gdgly/dca-270/DOC/上尚装置图片_160718/4.jpg

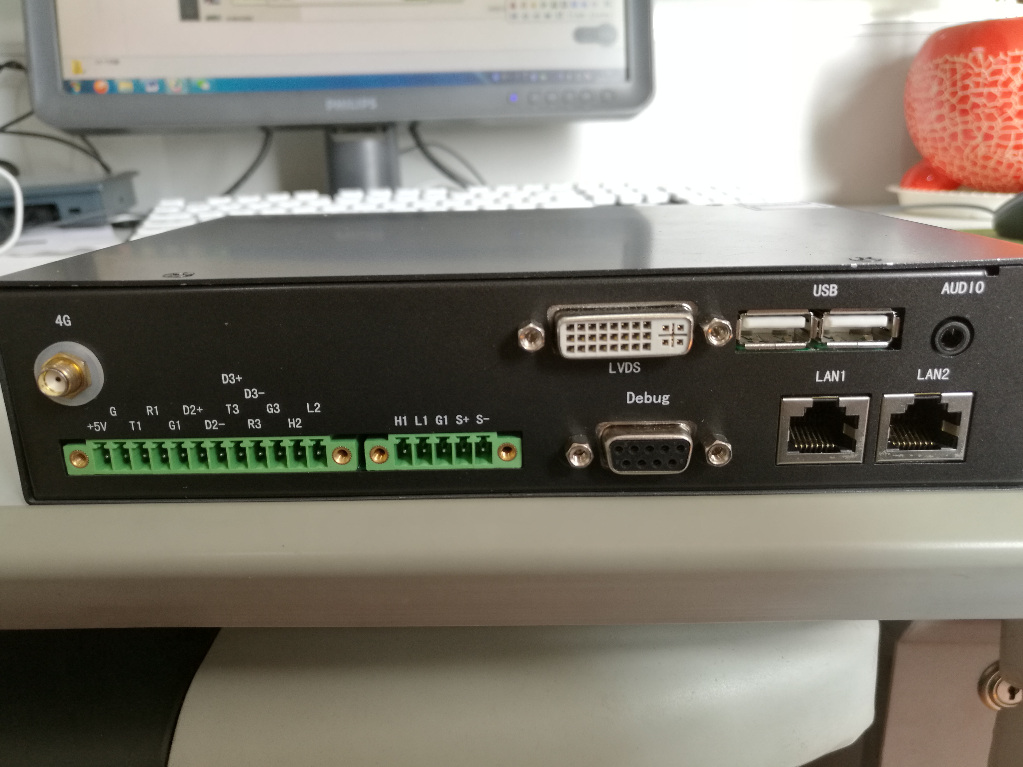
DOC/上尚装置图片_160718/4.jpg
