gdgly/dca-270/README.md

#DCA-270
* 该项目是根据许继技术中心需求而设计的产品，产品名称为*DCA-270*，对应许继的产品型号为*ECU-801*。
* 进行该产品的设计，是作为__网外直流桩的计费控制单元__推出，在价格上比*DCA-400*要低一些。
