gdgly/dca-270/DOC/上尚装置图片_160718/3.jpg

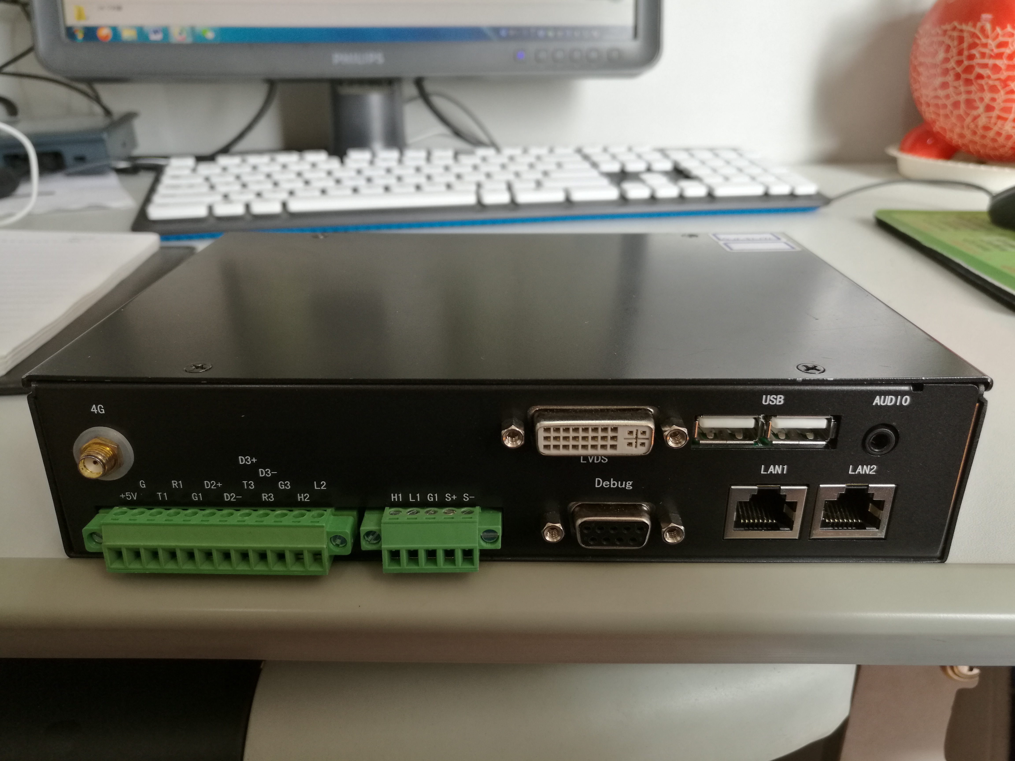
DOC/上尚装置图片_160718/3.jpg
