gdgly/dca-270/DOC/BOM清单上需要去掉的器件_160823.docx

1. 在DCA-270硬件上，考虑到冗余设计，增加了一些相对冗余的电路，可以把这些器件去掉，以起到节省成本的目的。
2. EB板上可以去掉的器件：

B3

C48、C50、

CE1、CE2、CE3、CE8、CE9、CE12、

CY2

DCDC1

R52

3. MB板上可以去掉的器件：

CE15、CE16、CE17、CE18、CE19、CE20、CE21、CE22、CE23
