gdgly/dca-270/SCH_160723/DCA_270_EB_V20_160723/dca_270_eb_v20_160723.pdf

D | D
C | C
B | B
A | A
1.0 | FEATURE CHANGES 1、完成1.0版本原理图设计。 说明：采用两层板设计方案。 2、2016.04.28：图纸做了修改，将MB板上的4G模块电源电路 和音频功放电路移到EB板上。这样MB板上就没有12V强电了。 | 04/20/16 | Jason
REV | DESCRIPTION | DATE | BY

# CONTENTS

PAGE NO. | SCHEMATIC PAGE
1 | 封面
2 | 板对板接插件：2 * 40pin 双排2.54mm插针
3 | RJ45电路
4 | RS232电路
5 | RS485电路
6 | CAN总线接口电路
7 | 2路DI开入电路
8 | 2路DO开出电路
9 | 音频放大电路
10 | 4G无线模块电源
11 | 12V输入，产生系统主3.3/5V电源
12 | 外部12V电源EMC滤波电路
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
2.0 | FEATURE CHANGES 1、按照克潇ECU801需求，重新改动图纸。 2、EB板上一共排布有7个端子，分别为： J1：电源端子 J2：DI开入端子 J3：DO开出端子 J7：串口端子 J8：CAN和音频端子 J9：DEBUG调试串口DB9母头 J10：以太网RJ45端口 | 07/23/16 | Jason

## Jason

标记 标记 标记 | 数量更改单号签名日期 更改 数量更改单号签名日期 更改 数量更改单号签名日期 更改 | | | 更改 更改 更改 标记 标记 标记 | 数量更改单号 数量更改单号 数量更改单号 | | 签名 签名日期 更改标记 数量更改单号 签名 签名日期 更改标记 数量更改单号 签名 签名日期 更改标记 数量更改单号 | 日期 日期 日期
拟制 拟制 拟制 | | Jason.Wang Jason.Wang Jason.Wang | COVER COVER COVER | | | DCA-270_EB DCA-270_EB DCA-270_EB
审核 审核 审核 | | <审核> <审核> <审核>
批准 | <批准>
版本 | 第　　张 | 共　　张
V2.0 V2.0 V2.0 | 1 1 1 | 12 12 12

# 标准化

注意：

# 该接插件可放置在板子的左边。

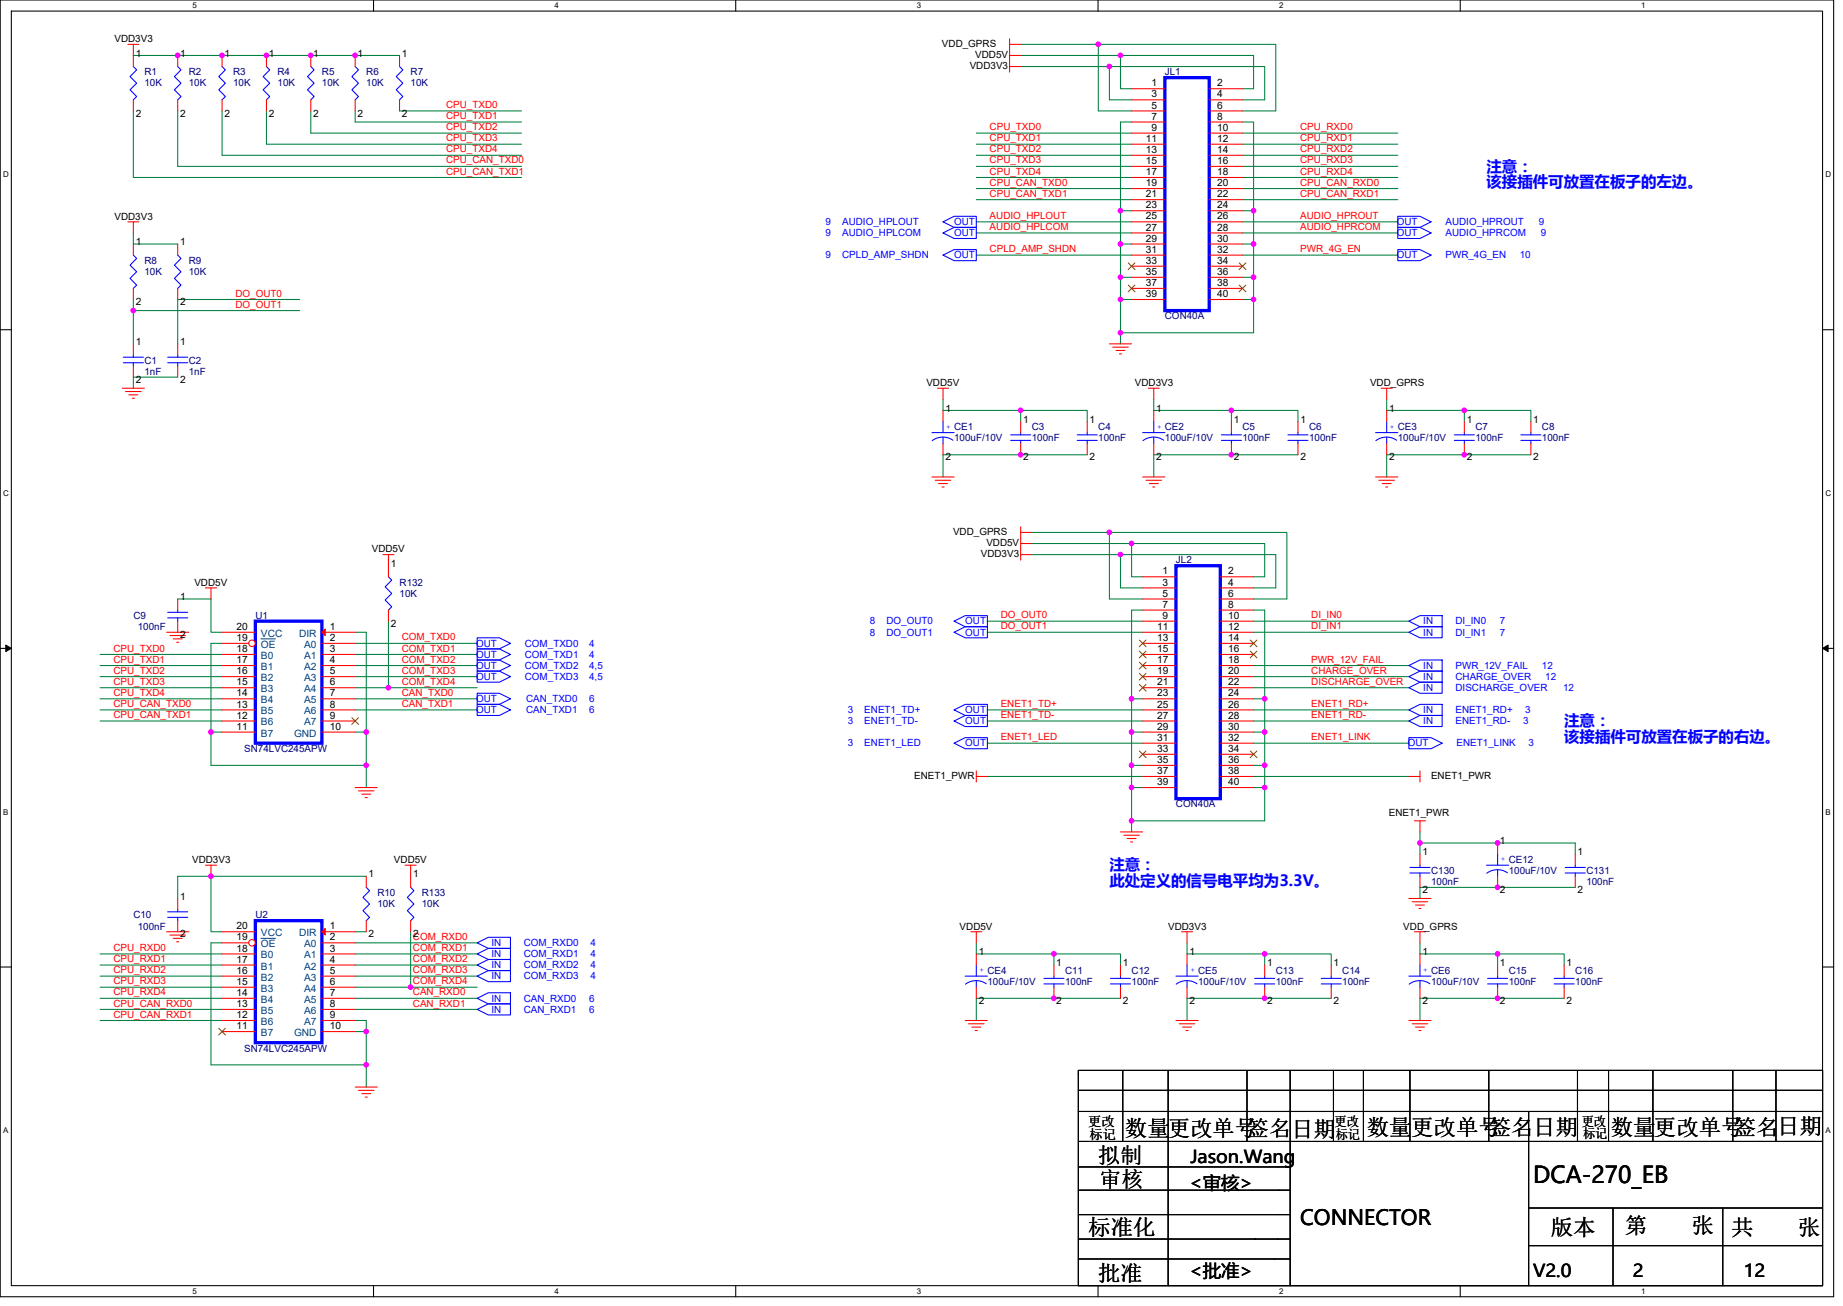
[picture p11: page 2]

37 | 38
39 | 40

标记 标记 标记 | 数量更改单号签名日期 更改 数量更改单号签名日期 更改 数量更改单号签名日期 更改 | | | 更改 更改 更改 标记 标记 标记 | 数量更改单号 数量更改单号 数量更改单号 | | 签名 签名日期 更改标记 数量更改单号 签名 签名日期 更改标记 数量更改单号 签名 签名日期 更改标记 数量更改单号 | 日期 日期 日期
拟制 拟制 拟制 | | Jason.Wang Jason.Wang Jason.Wang | CONNECTOR CONNECTOR CONNECTOR | | | DCA-270_EB DCA-270_EB DCA-270_EB
审核 审核 审核 | | <审核> <审核> <审核>

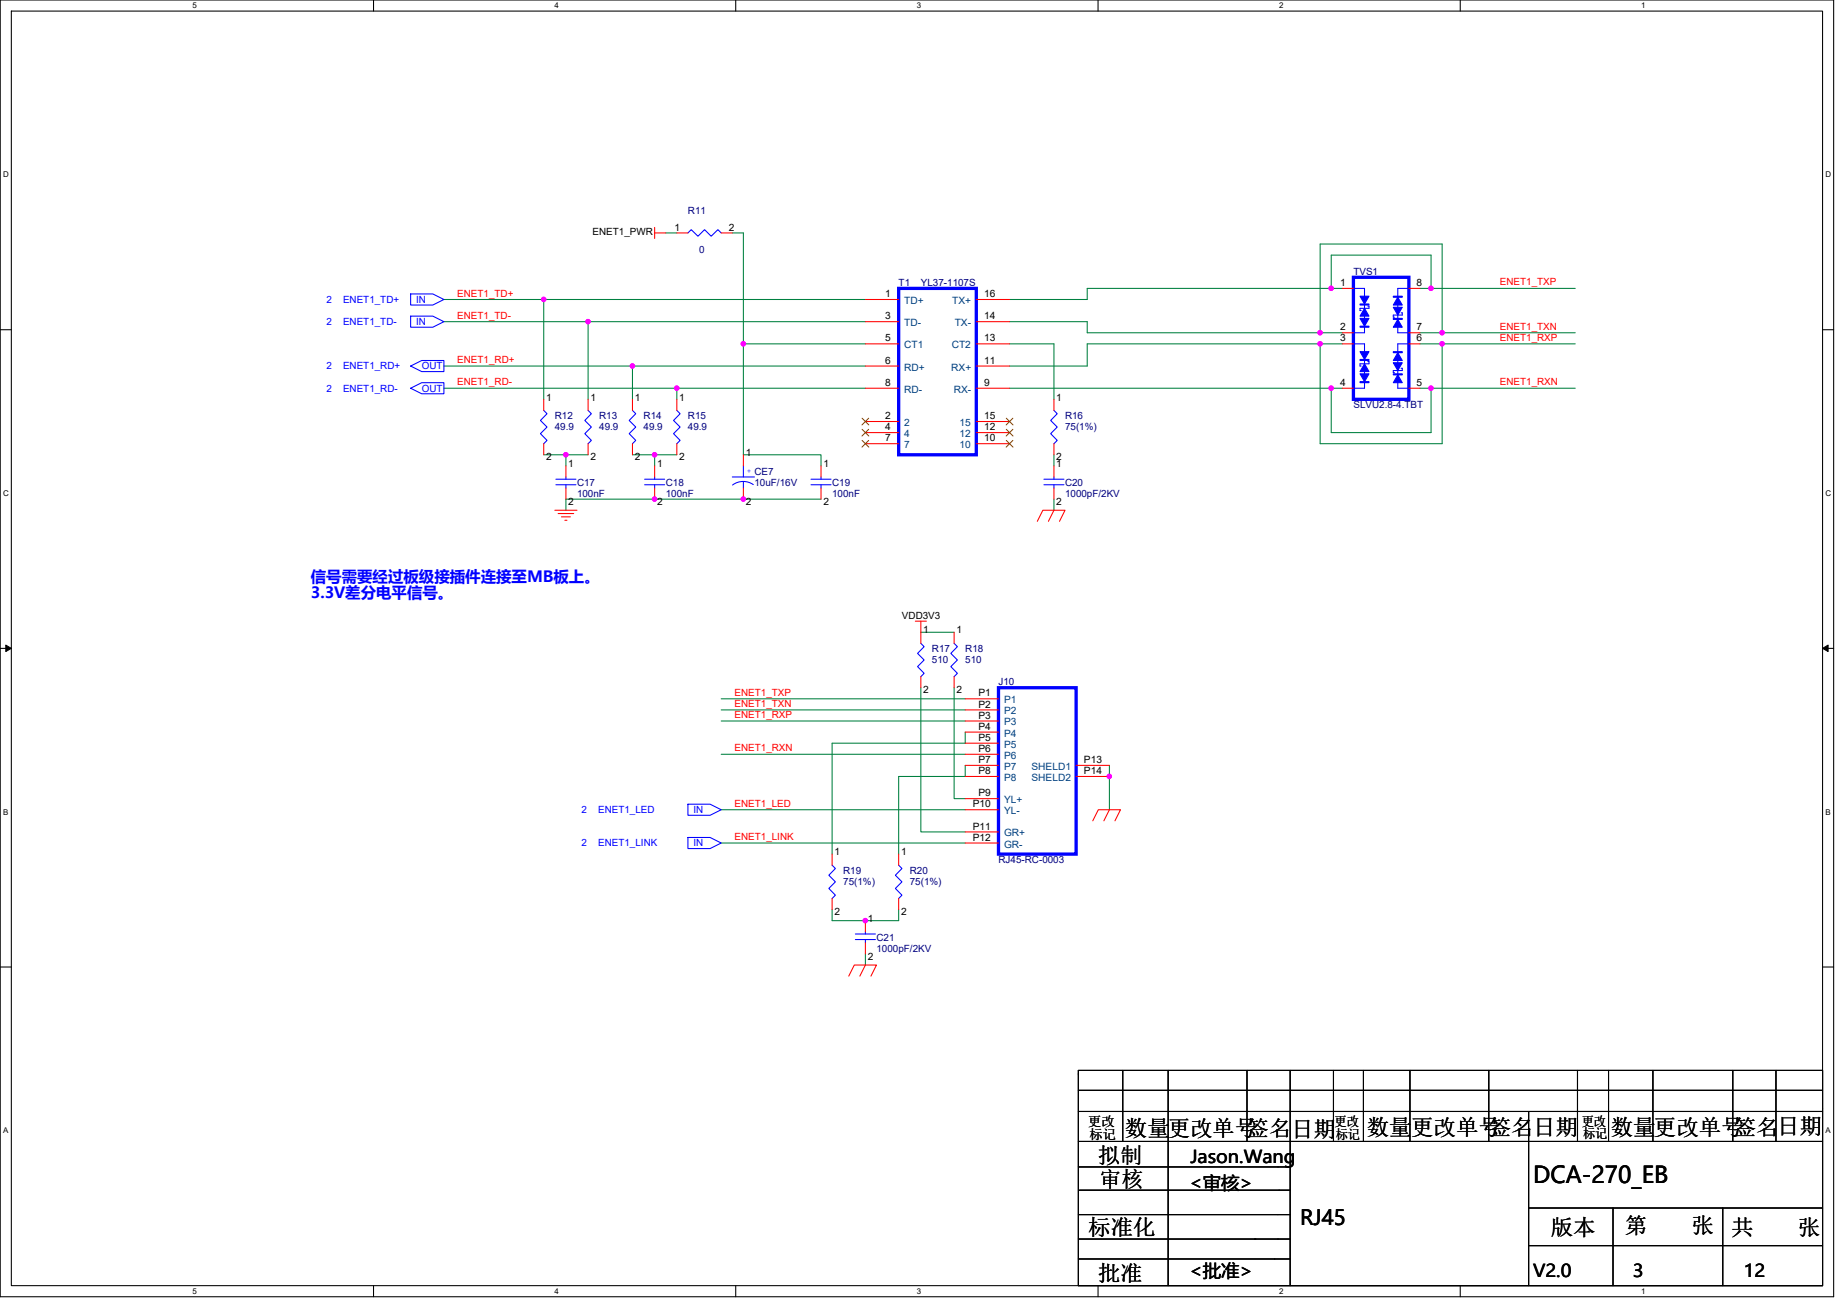
[picture p12: page 3]

标记 标记 标记 | 数量更改单号签名日期 更改 数量更改单号签名日期 更改 数量更改单号签名日期 更改 | | | 更改 更改 更改 标记 标记 标记 | 数量更改单号 数量更改单号 数量更改单号 | | 签名 签名日期 更改标记 数量更改单号 签名 签名日期 更改标记 数量更改单号 签名 签名日期 更改标记 数量更改单号 | 日期 日期 日期
拟制 拟制 拟制 | | Jason.Wang Jason.Wang Jason.Wang | RJ45 RJ45 RJ45 | | | DCA-270_EB DCA-270_EB DCA-270_EB
审核 审核 审核 | | <审核> <审核> <审核>

# 采用90度弯针DB9母头。

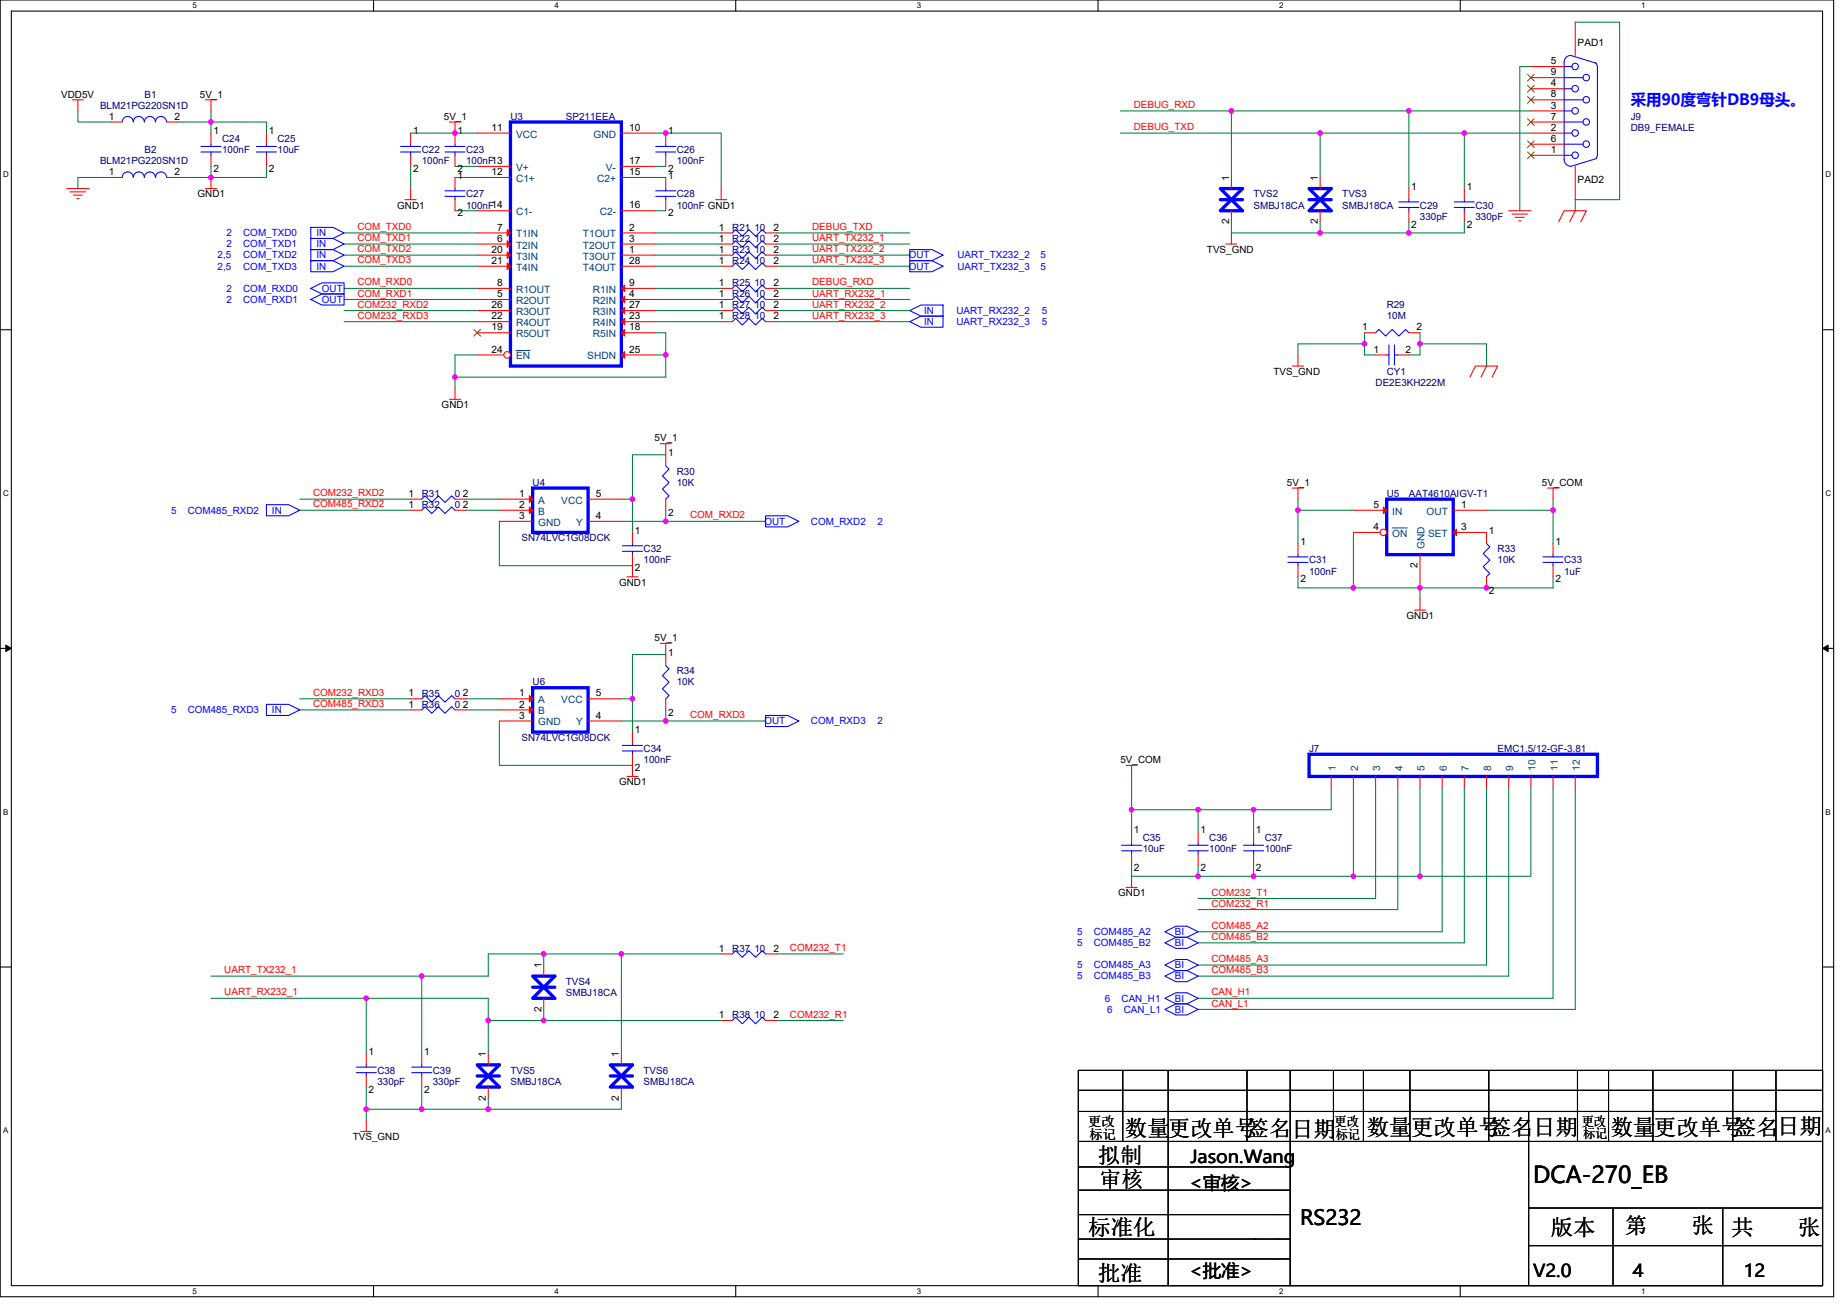
[picture p13: page 4]

COM232_T1

标记 标记 标记 | 数量更改单号签名日期 更改 数量更改单号签名日期 更改 数量更改单号签名日期 更改 | | | 更改 更改 更改 标记 标记 标记 | 数量更改单号 数量更改单号 数量更改单号 | | 签名 签名日期 更改标记 数量更改单号 签名 签名日期 更改标记 数量更改单号 签名 签名日期 更改标记 数量更改单号 | 日期 日期 日期
拟制 拟制 拟制 | | Jason.Wang Jason.Wang Jason.Wang | RS232 RS232 RS232 | | | DCA-270_EB DCA-270_EB DCA-270_EB
审核 审核 审核 | | <审核> <审核> <审核>

注意：

# 本页图纸统一将上下拉电阻改为560欧姆

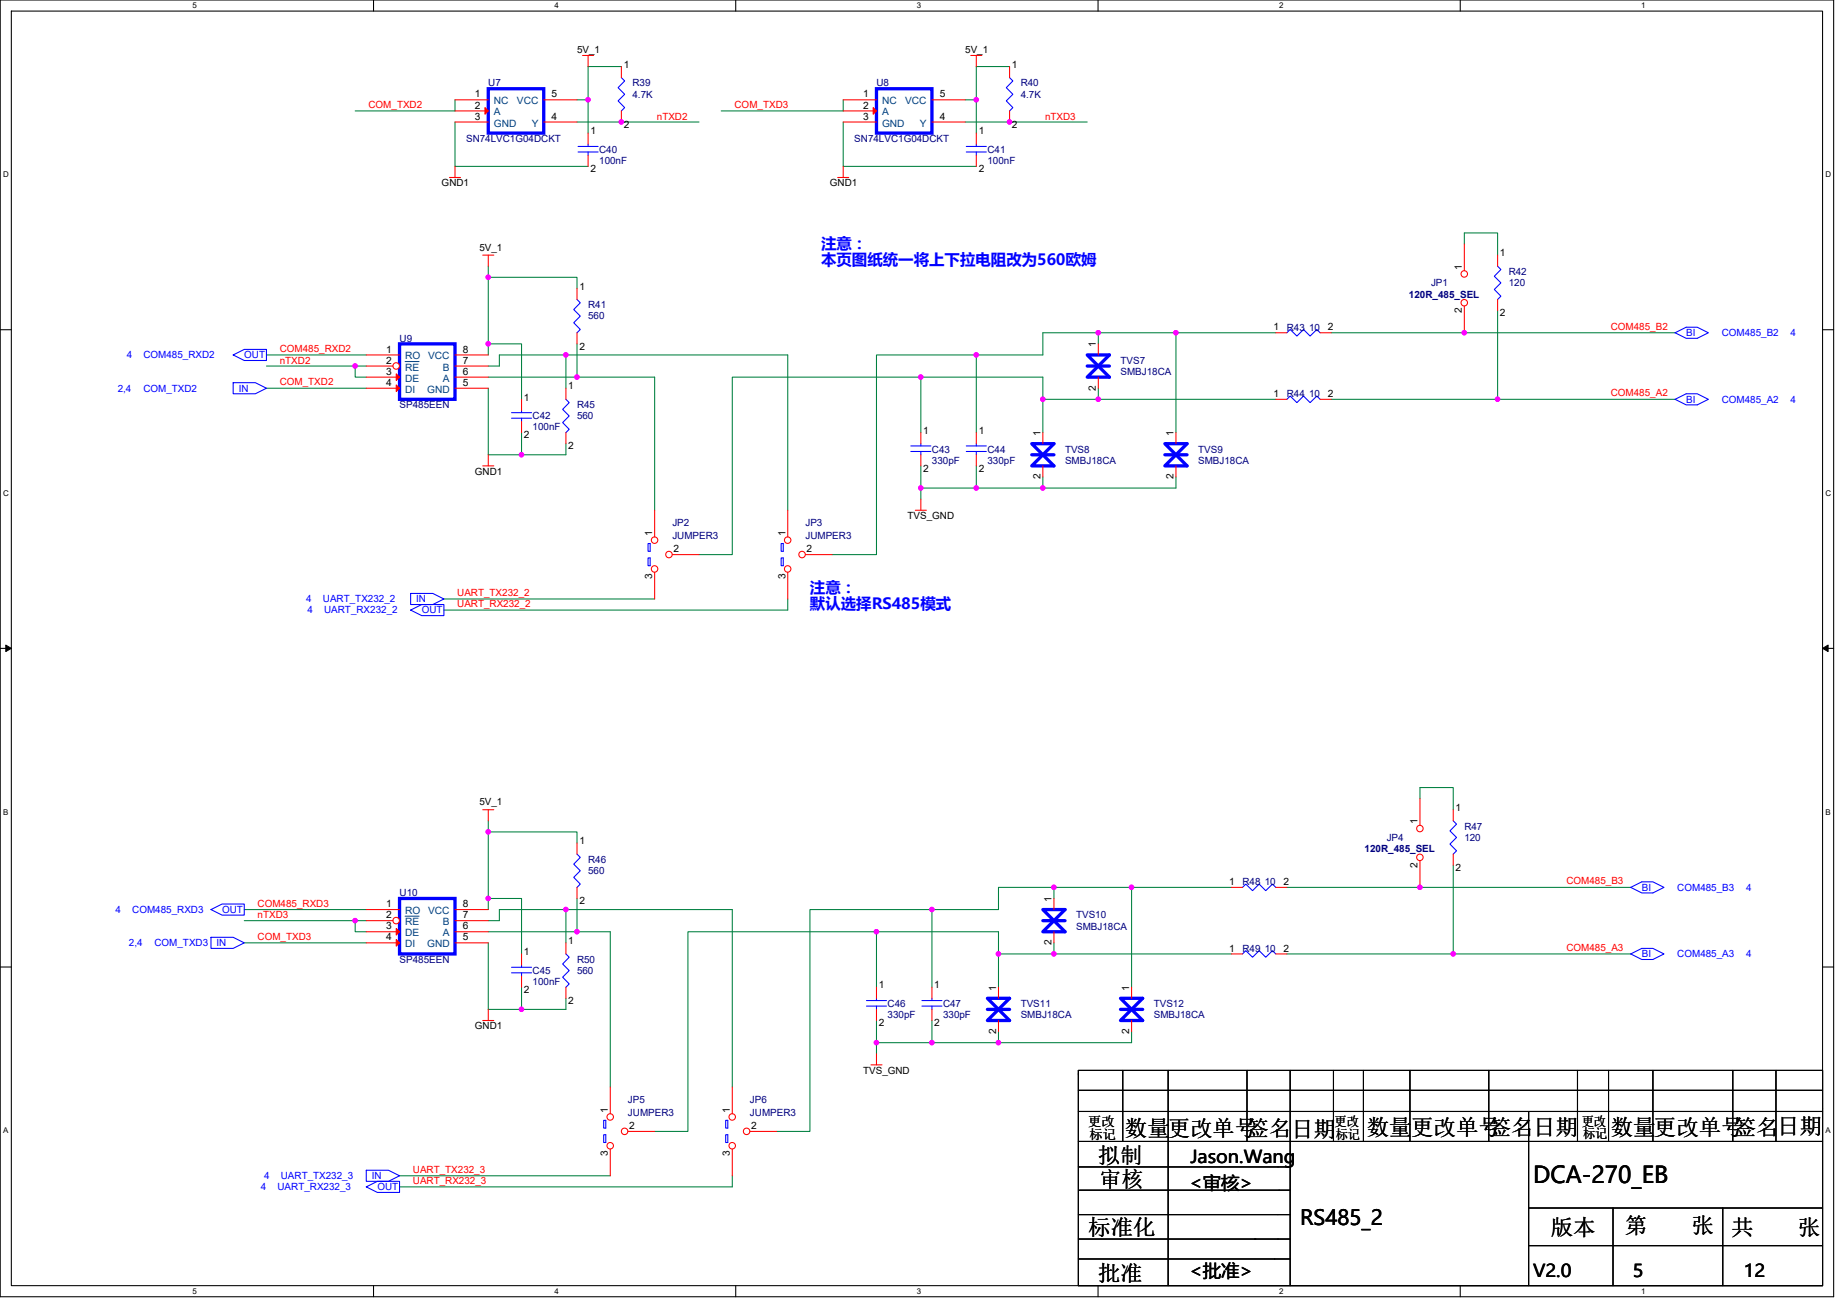
[picture p14: page 5]

标记 标记 标记 | 数量更改单号签名日期 更改 数量更改单号签名日期 更改 数量更改单号签名日期 更改 | | | 更改 更改 更改 标记 标记 标记 | 数量更改单号 数量更改单号 数量更改单号 | | 签名 签名日期 更改标记 数量更改单号 签名 签名日期 更改标记 数量更改单号 签名 签名日期 更改标记 数量更改单号 | 日期 日期 日期
拟制 拟制 拟制 | | Jason.Wang Jason.Wang Jason.Wang | RS485_2 RS485_2 RS485_2 | | | DCA-270_EB DCA-270_EB DCA-270_EB
审核 审核 审核 | | <审核> <审核> <审核>

# 考虑成本，该部分电路不焊接。

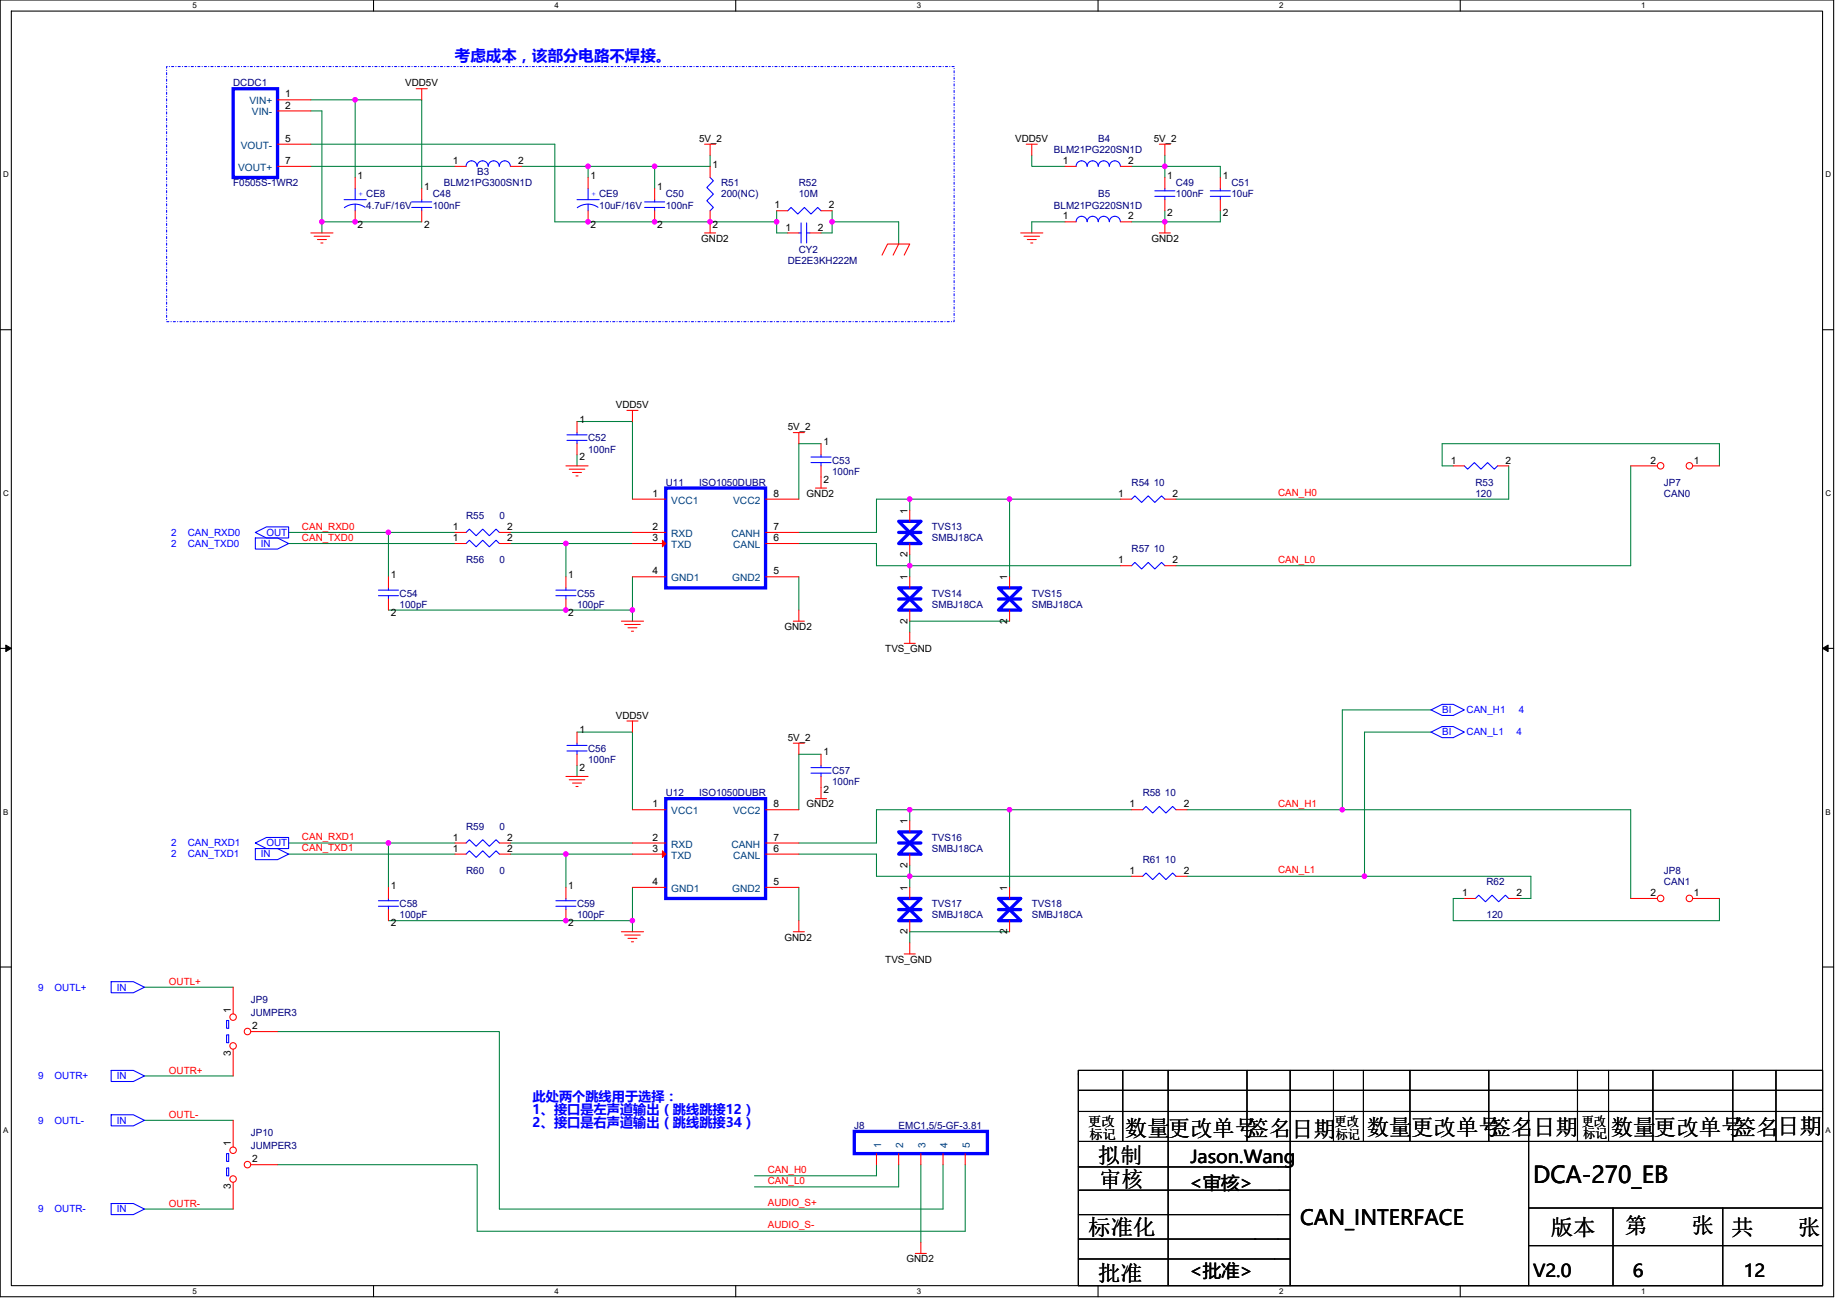
[picture p15: page 6]

OUTL+ OUTR+ OUTL- OUTR-

标记 标记 标记 | 数量更改单号签名日期 更改 数量更改单号签名日期 更改 数量更改单号签名日期 更改 | | | 更改 更改 更改 标记 标记 标记 | 数量更改单号 数量更改单号 数量更改单号 | | 签名 签名日期 更改标记 数量更改单号 签名 签名日期 更改标记 数量更改单号 签名 签名日期 更改标记 数量更改单号 | 日期 日期 日期
拟制 拟制 拟制 | | Jason.Wang Jason.Wang Jason.Wang | CAN_INTERFACE CAN_INTERFACE CAN_INTERFACE | | | DCA-270_EB DCA-270_EB DCA-270_EB
审核 审核 审核 | | <审核> <审核> <审核>

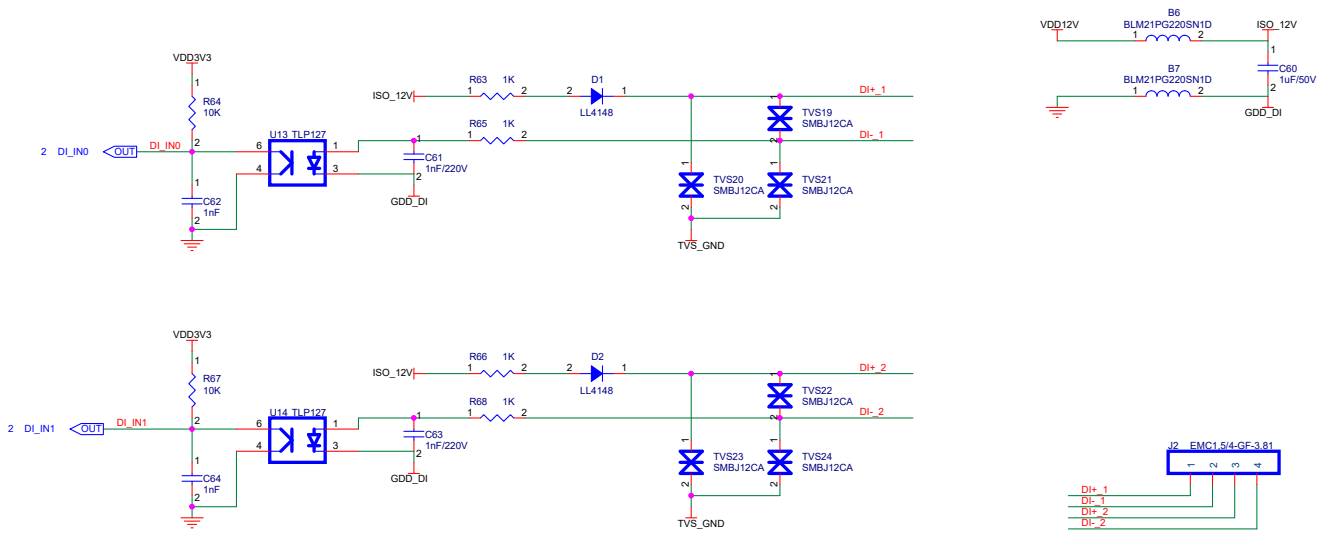
[picture p16: page 7]

标记 标记 标记 | 数量更改单号签名日期 更改 数量更改单号签名日期 更改 数量更改单号签名日期 更改 | | | 更改 更改 更改 标记 标记 标记 | 数量更改单号 数量更改单号 数量更改单号 | | 签名 签名日期 更改标记 数量更改单号 签名 签名日期 更改标记 数量更改单号 签名 签名日期 更改标记 数量更改单号 | 日期 日期 日期
拟制 拟制 拟制 | | Jason.Wang Jason.Wang Jason.Wang | DIO INPUT DIO INPUT DIO INPUT | | | DCA-270_EB DCA-270_EB DCA-270_EB
审核 审核 审核 | | <审核> <审核> <审核>

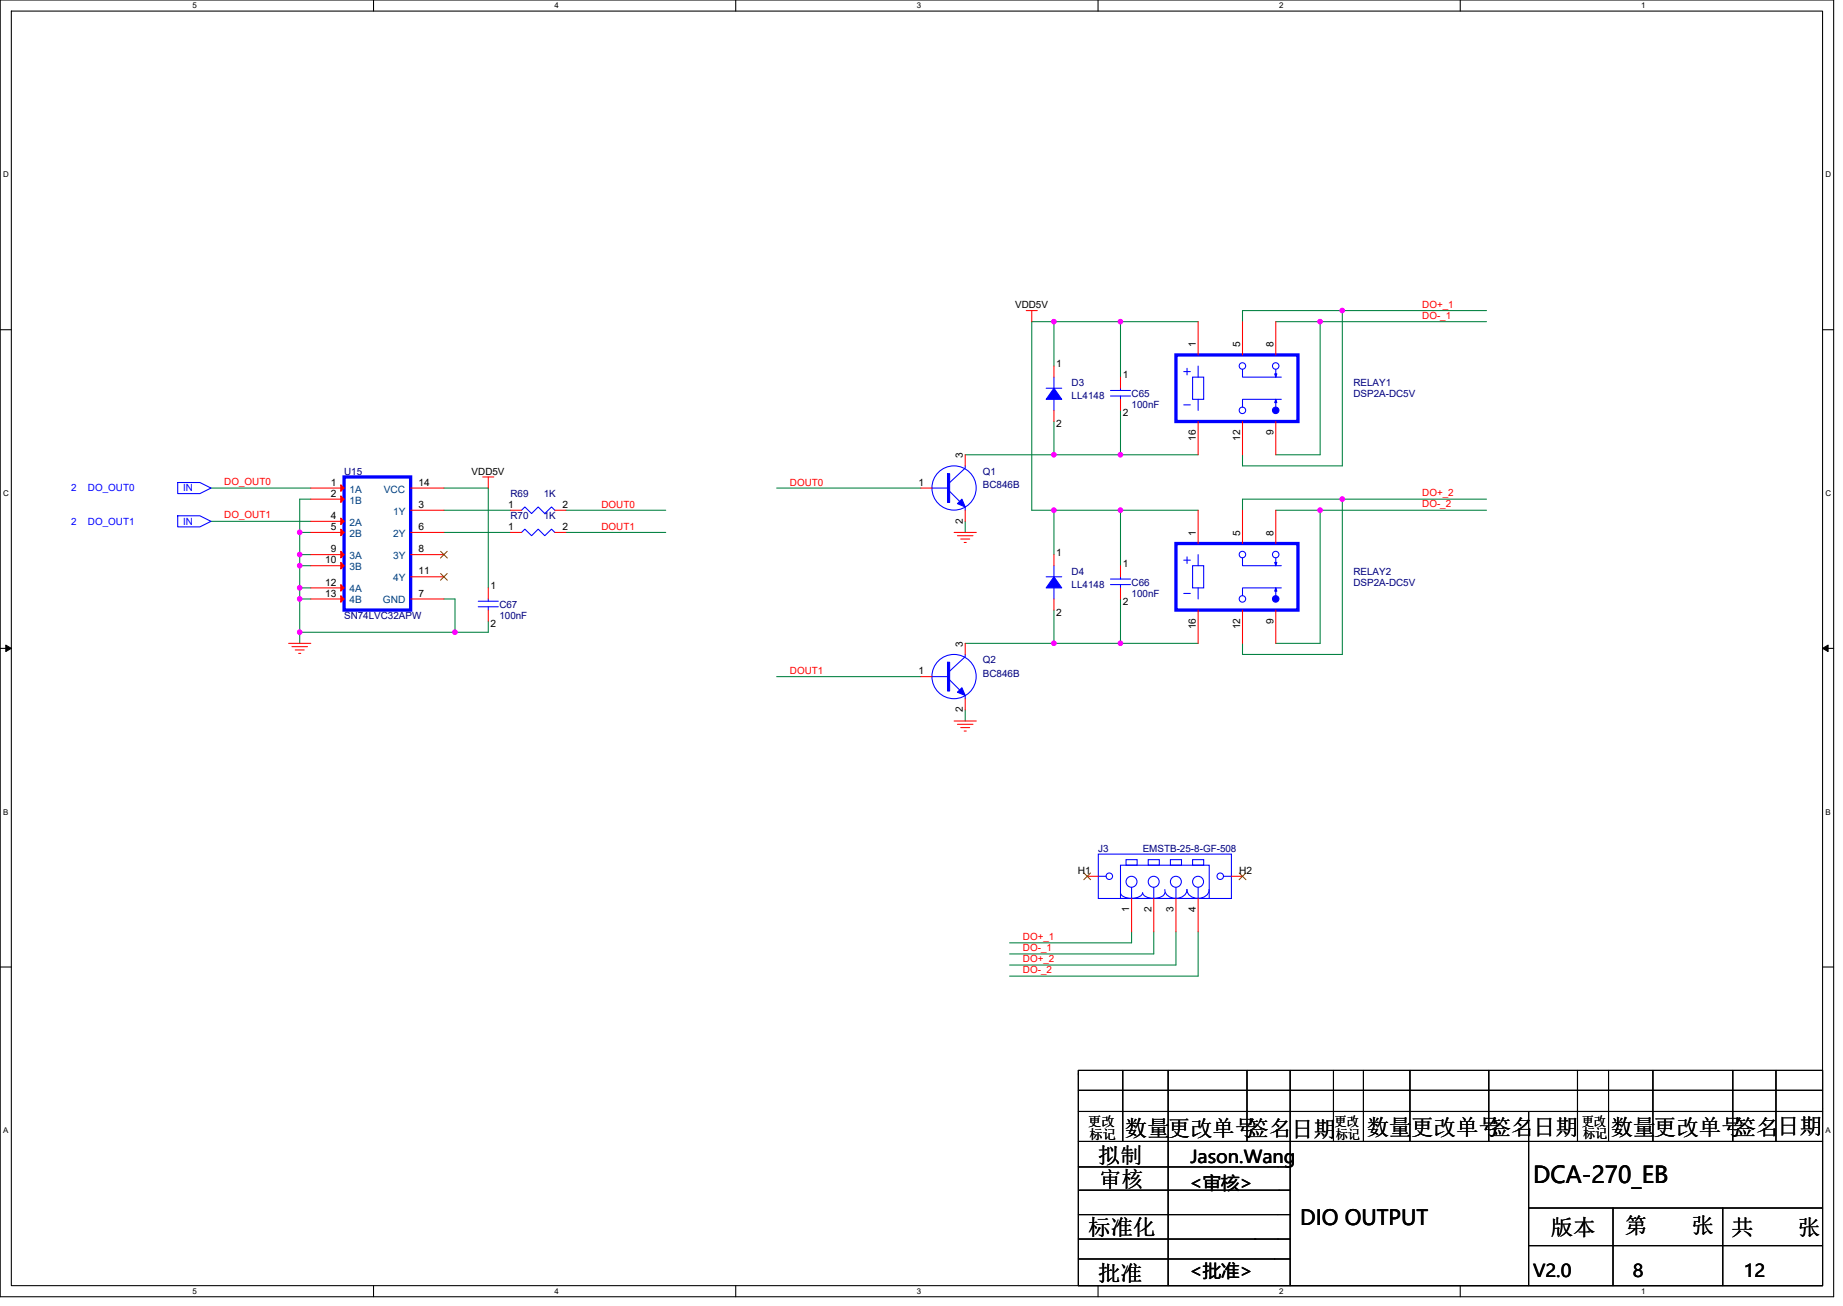
[picture p17: page 8]

标记 标记 标记 | 数量更改单号签名日期 更改 数量更改单号签名日期 更改 数量更改单号签名日期 更改 | | | 更改 更改 更改 标记 标记 标记 | 数量更改单号 数量更改单号 数量更改单号 | | 签名 签名日期 更改标记 数量更改单号 签名 签名日期 更改标记 数量更改单号 签名 签名日期 更改标记 数量更改单号 | 日期 日期 日期
拟制 拟制 拟制 | | Jason.Wang Jason.Wang Jason.Wang | DIO OUTPUT DIO OUTPUT DIO OUTPUT | | | DCA-270_EB DCA-270_EB DCA-270_EB
审核 审核 审核 | | <审核> <审核> <审核>

D | D

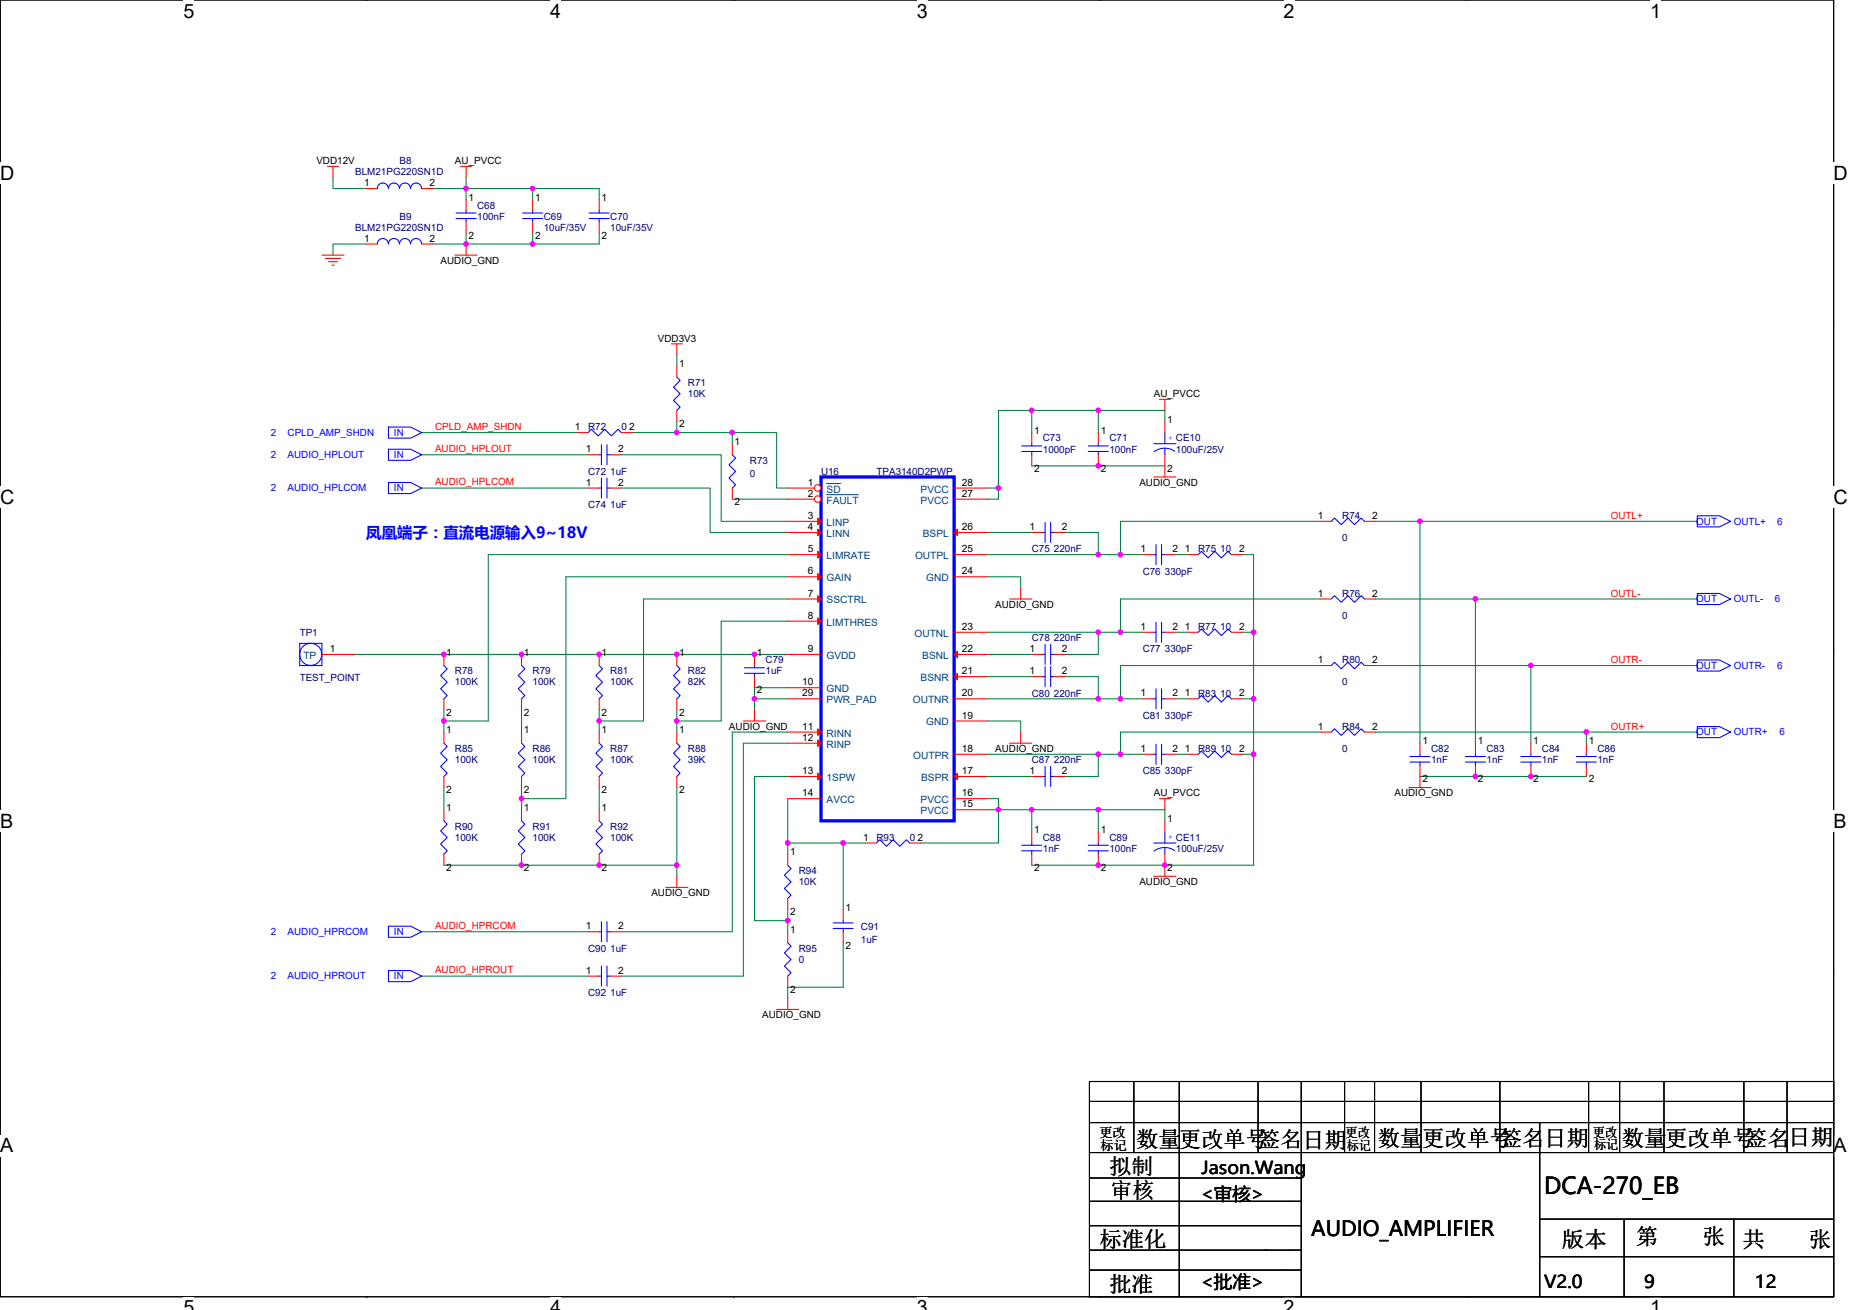
[picture p18: page 9]

标记 标记 标记 | 数量更改单号签名日期 更改 数量更改单号签名日期 更改 数量更改单号签名日期 更改 | | | 更改 更改 更改 标记 标记 标记 | 数量更改单号 数量更改单号 数量更改单号 | | 签名 签名日期 更改标记 数量更改单号 签名 签名日期 更改标记 数量更改单号 签名 签名日期 更改标记 数量更改单号 | 日期 日期 日期
拟制 拟制 拟制 | | Jason.Wang Jason.Wang Jason.Wang | AUDIO_AMPLIFIER AUDIO_AMPLIFIER AUDIO_AMPLIFIER | | | DCA-270_EB DCA-270_EB DCA-270_EB
审核 审核 审核 | | <审核> <审核> <审核>

D | D

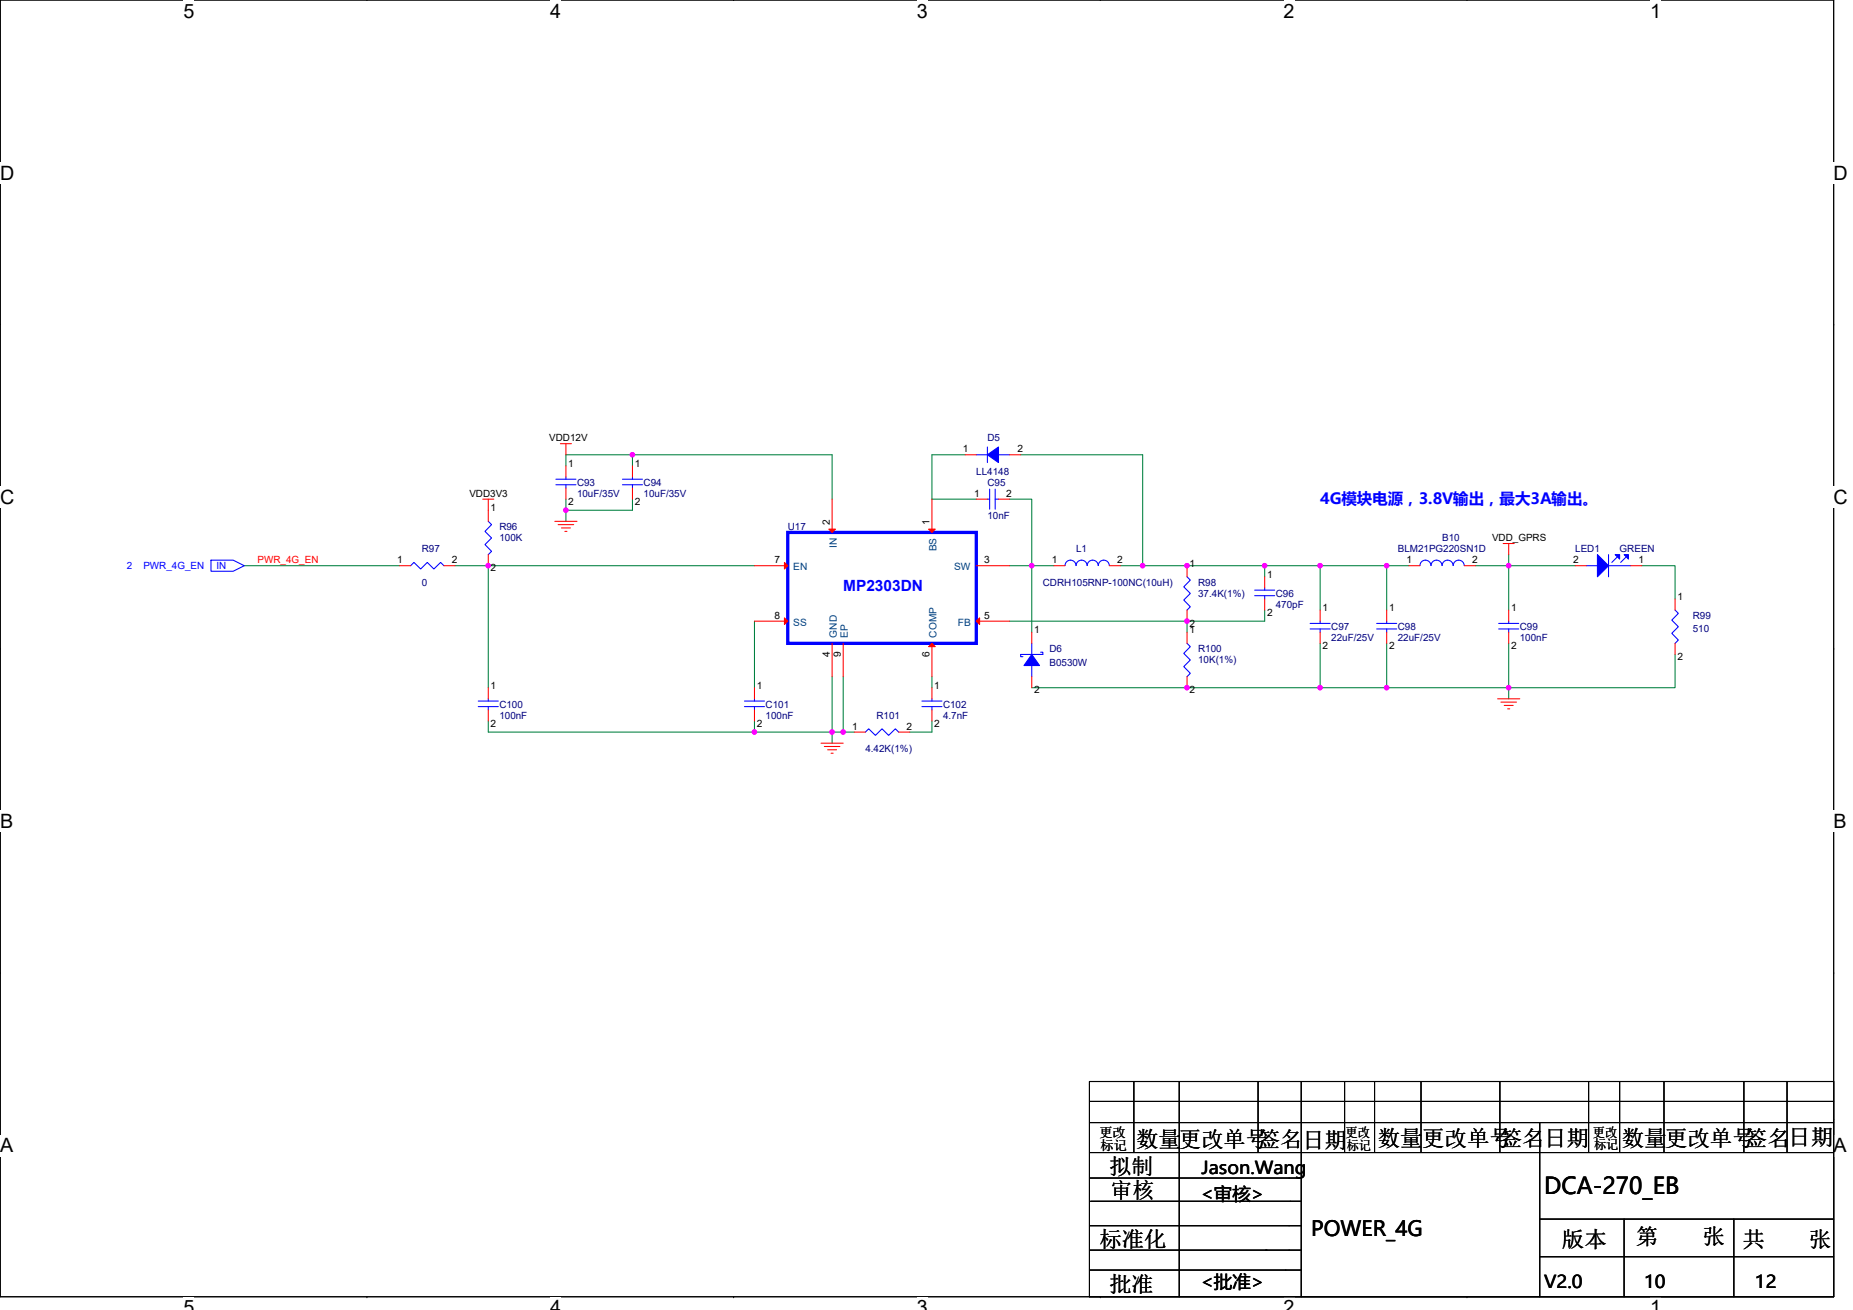
[picture p19: page 10]

标记 标记 标记 | 数量更改单号签名日期 更改 数量更改单号签名日期 更改 数量更改单号签名日期 更改 | | | 更改 更改 更改 标记 标记 标记 | 数量更改单号 数量更改单号 数量更改单号 | | 签名 签名日期 更改标记 数量更改单号 签名 签名日期 更改标记 数量更改单号 签名 签名日期 更改标记 数量更改单号 | 日期 日期 日期
拟制 拟制 拟制 | | Jason.Wang Jason.Wang Jason.Wang | POWER_4G POWER_4G POWER_4G | | | DCA-270_EB DCA-270_EB DCA-270_EB
审核 审核 审核 | | <审核> <审核> <审核>

# 系统主5V电源，最大3A输出。

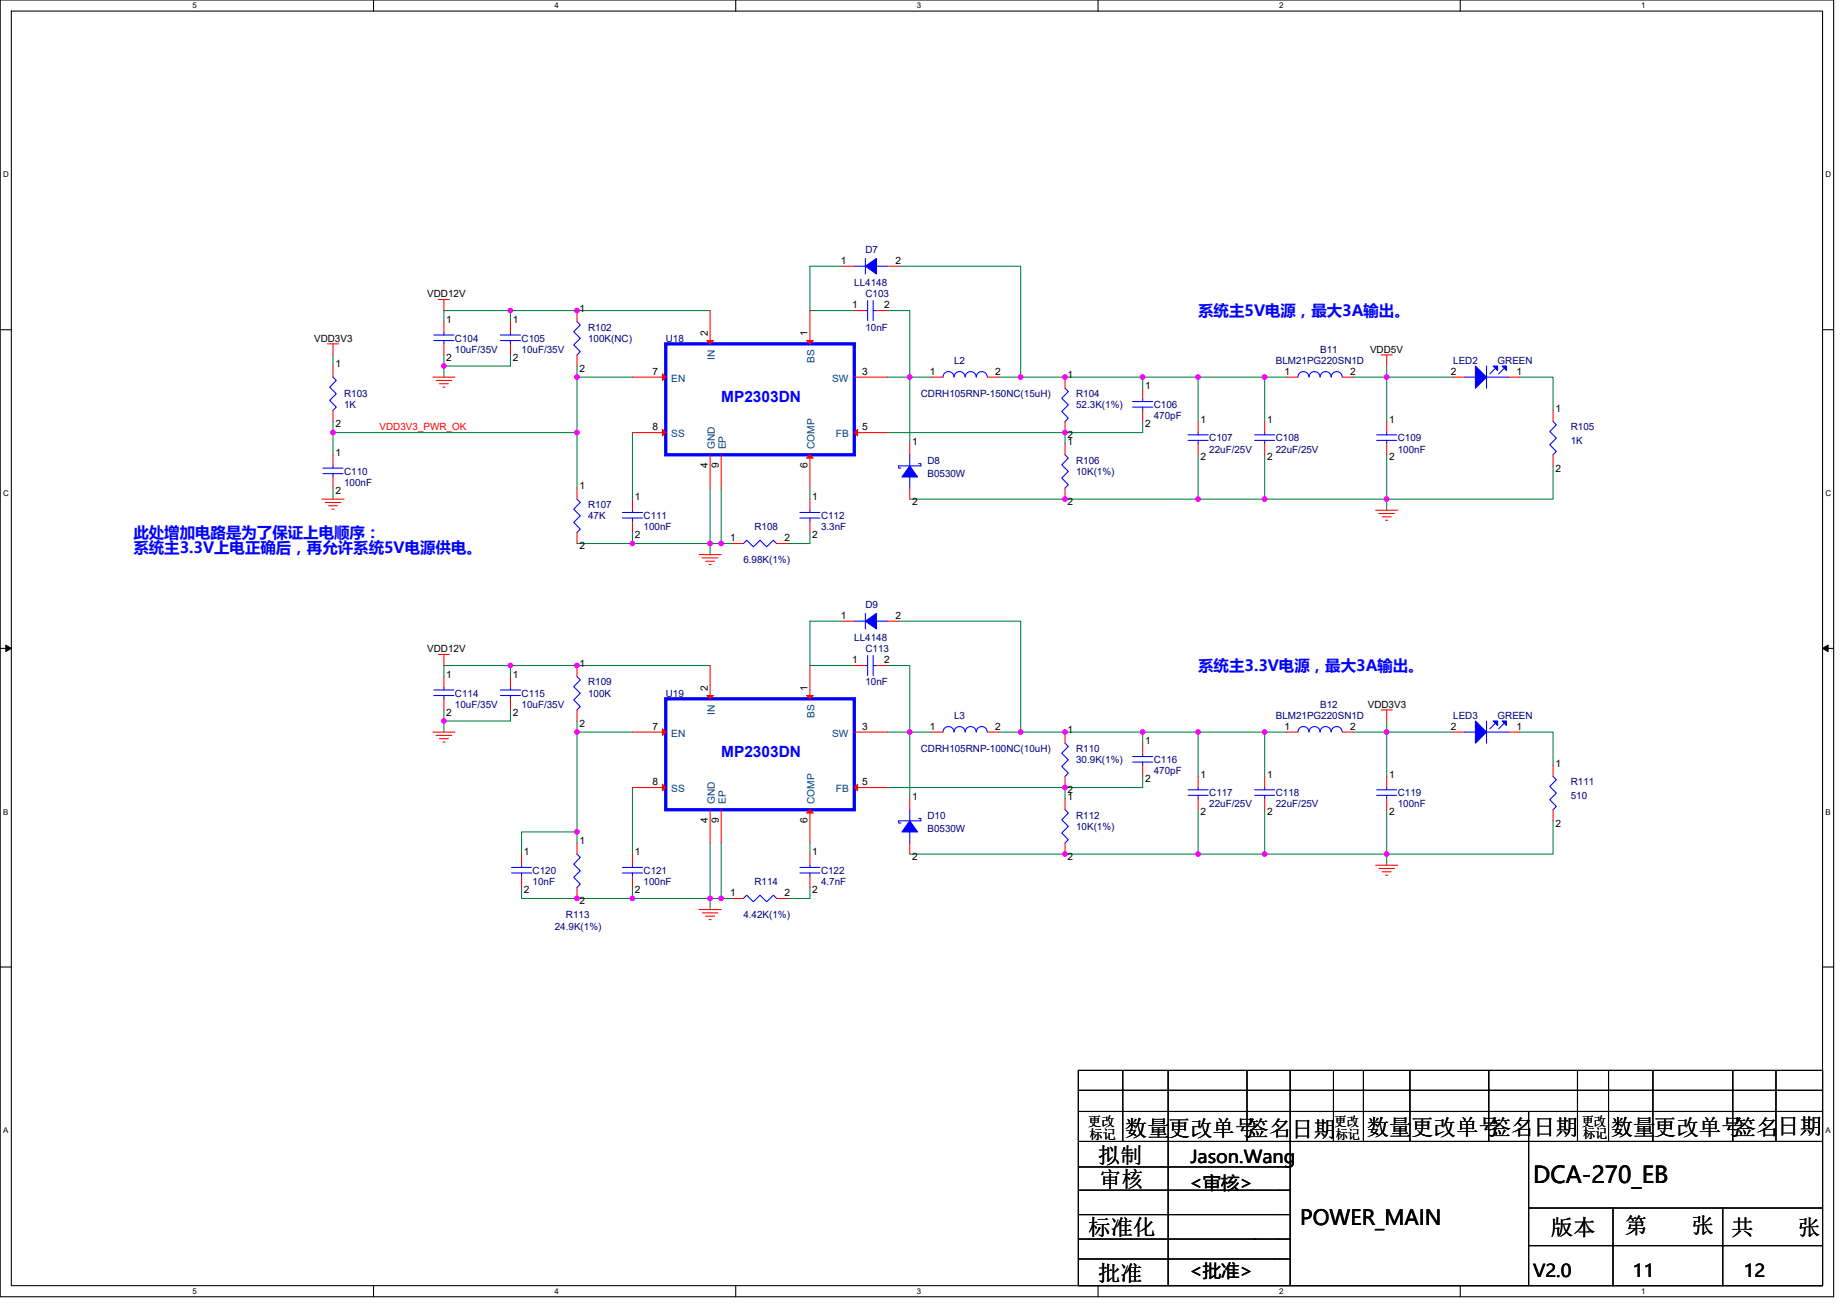
[picture p20: page 11]

标记 标记 标记 | 数量更改单号签名日期 更改 数量更改单号签名日期 更改 数量更改单号签名日期 更改 | | | 更改 更改 更改 标记 标记 标记 | 数量更改单号 数量更改单号 数量更改单号 | | 签名 签名日期 更改标记 数量更改单号 签名 签名日期 更改标记 数量更改单号 签名 签名日期 更改标记 数量更改单号 | 日期 日期 日期
拟制 拟制 拟制 | | Jason.Wang Jason.Wang Jason.Wang | POWER_MAIN POWER_MAIN POWER_MAIN | | | DCA-270_EB DCA-270_EB DCA-270_EB
审核 审核 审核 | | <审核> <审核> <审核>

# 凤凰端子：直流电源输入9~18V

## 超级电容

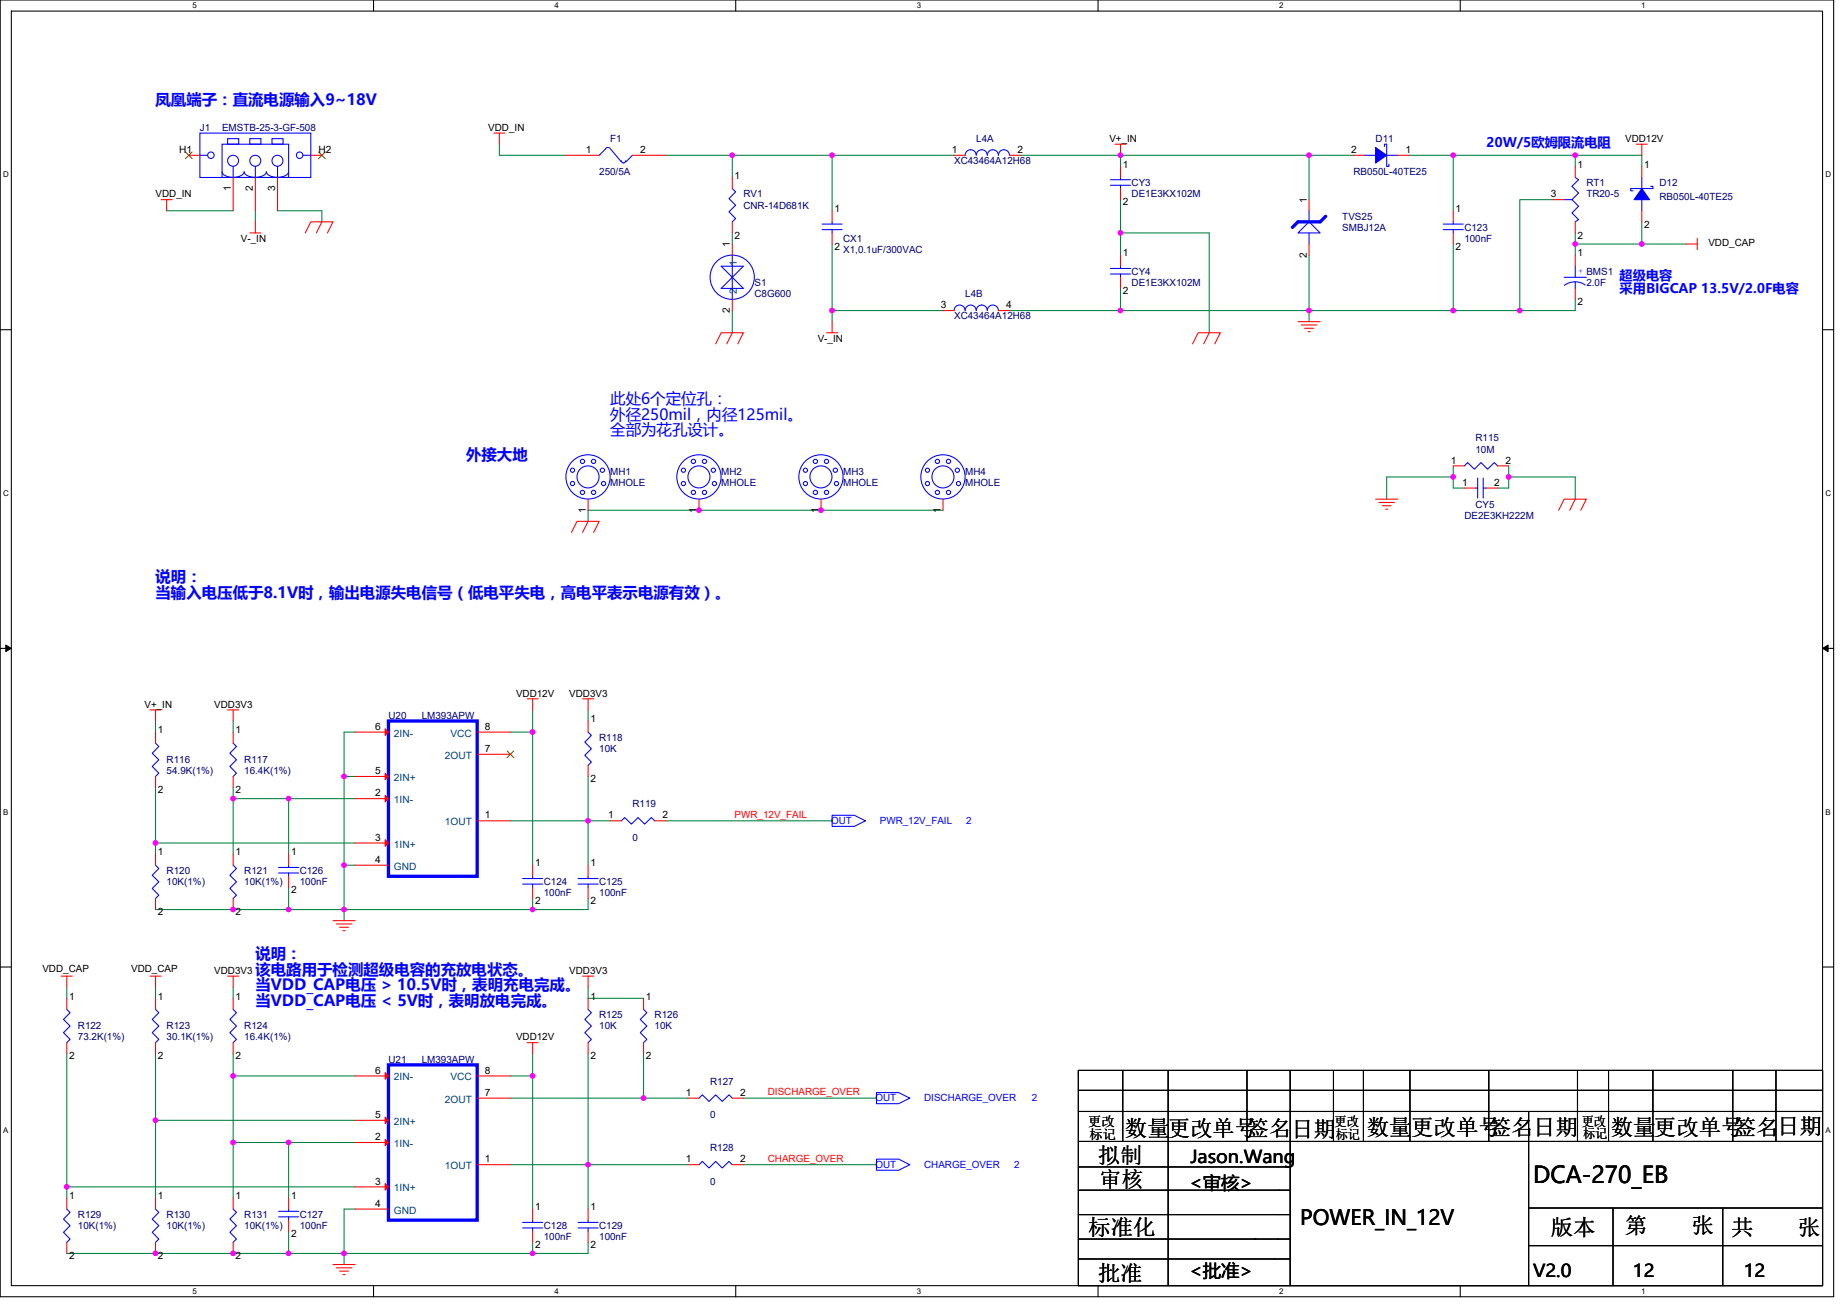
[picture p21: page 12]

GND 4
