gdgly/dca-270/SCH_160723/DCA_270_MB_V20_160723/dca_270_mb_v20_160723.pdf

D | D
C | C
B | B
A | A
1.0 | FEATURE CHANGES 1、完成1.0版本原理图设计。 结构上仍然采用两块板设计方案， 将5路串口，两路CAN口，3路DI，4路DO放置底板， 要求MB板采用4层板设计方案。 2、2016.05.05：修改了图纸设计，从MB板上去掉了音频功放电路， 去掉了4G模块电源电路，将这些电路移到EB板上。 | 04/20/16 | Jason
REV | DESCRIPTION | DATE | BY

# CONTENTS

PAGE NO. | SCHEMATIC PAGE
1 | 封面
2 | 系统逻辑框图
3 | 核心板接插件1：LOCAL_BUS
4 | 核心板接插件2：各种外设
5 | 地址线/数据线扩展
6 | CPLD：采用EPM240
7 | 第一路以太网PHY：采用KSZ8041FTL
8 | LVDS 显示驱动电路
9 | PCIE接口ME909S 4G模块电路
10 | ESAM/PSAM电路
11 | TF卡电路（Micro SD）
12 | 音频输出电路
13 | 8路LED信号指示灯
14 | OTHERS电路：包含蜂鸣器，USB HOST接口
15 | 与底板接插件接口电路
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
2.0 | FEATURE CHANGES 1、按照新的ECU801文档需求改动MB板设计。 2、要求MB采用4层板设计方案。 3、核心板需要放置在MB板的背面，满足高度44mm要求。 4、mini PCIE插槽需要放置在MB板背面，满足高度44mm需求。 | 07/23/16

2.1

标记 标记 标记 | 数量更改单号签名日期 更改 数量更改单号签名日期 更改 数量更改单号签名日期 更改 | | | 更改 更改 更改 标记 标记 标记 | 数量更改单号 数量更改单号 数量更改单号 | | 签名 签名日期 更改标记 数量更改单号 签名 签名日期 更改标记 数量更改单号 签名 签名日期 更改标记 数量更改单号 | 日期 日期 日期
拟制 拟制 拟制 | | Jason.Wang Jason.Wang Jason.Wang | COVER COVER COVER | | | DCA-270_MB DCA-270_MB DCA-270_MB
审核 审核 审核 | | <审核> <审核> <审核>
批准 | <批准>
版本 | 第　　张 | 共　　张
V2.0 V2.0 V2.0 | 1 1 1 | 15 15 15

# 标准化

D | D
C | C
B | B
A | A
LOCAL_BUS | SWA3304

# LVDS

# KSZ8041FTL

# CPLD EPM240T100

# ESAM

# DIO

# DI X 2 DO X 2

RJ45

USB 2.0/CAN | USB/CAN
UART X 6 | RS232/485
标记 标记 标记 | 数量更改单号签名日期 更改 数量更改单号签名日期 更改 数量更改单号签名日期 更改 | | | 更改 更改 更改 标记 标记 标记 | 数量更改单号 数量更改单号 数量更改单号 | | 签名 签名日期 更改标记 数量更改单号 签名 签名日期 更改标记 数量更改单号 签名 签名日期 更改标记 数量更改单号 | 日期 日期 日期
拟制 拟制 拟制 | | Jason.Wang Jason.Wang Jason.Wang | SYS_LOGIC SYS_LOGIC SYS_LOGIC | | | DCA-270_MB DCA-270_MB DCA-270_MB
审核 审核 审核 | | <审核> <审核> <审核>
V2.0 | 2 | 15
V2.0 | 2 | 15
V2.0 | 2 | 15

D | D

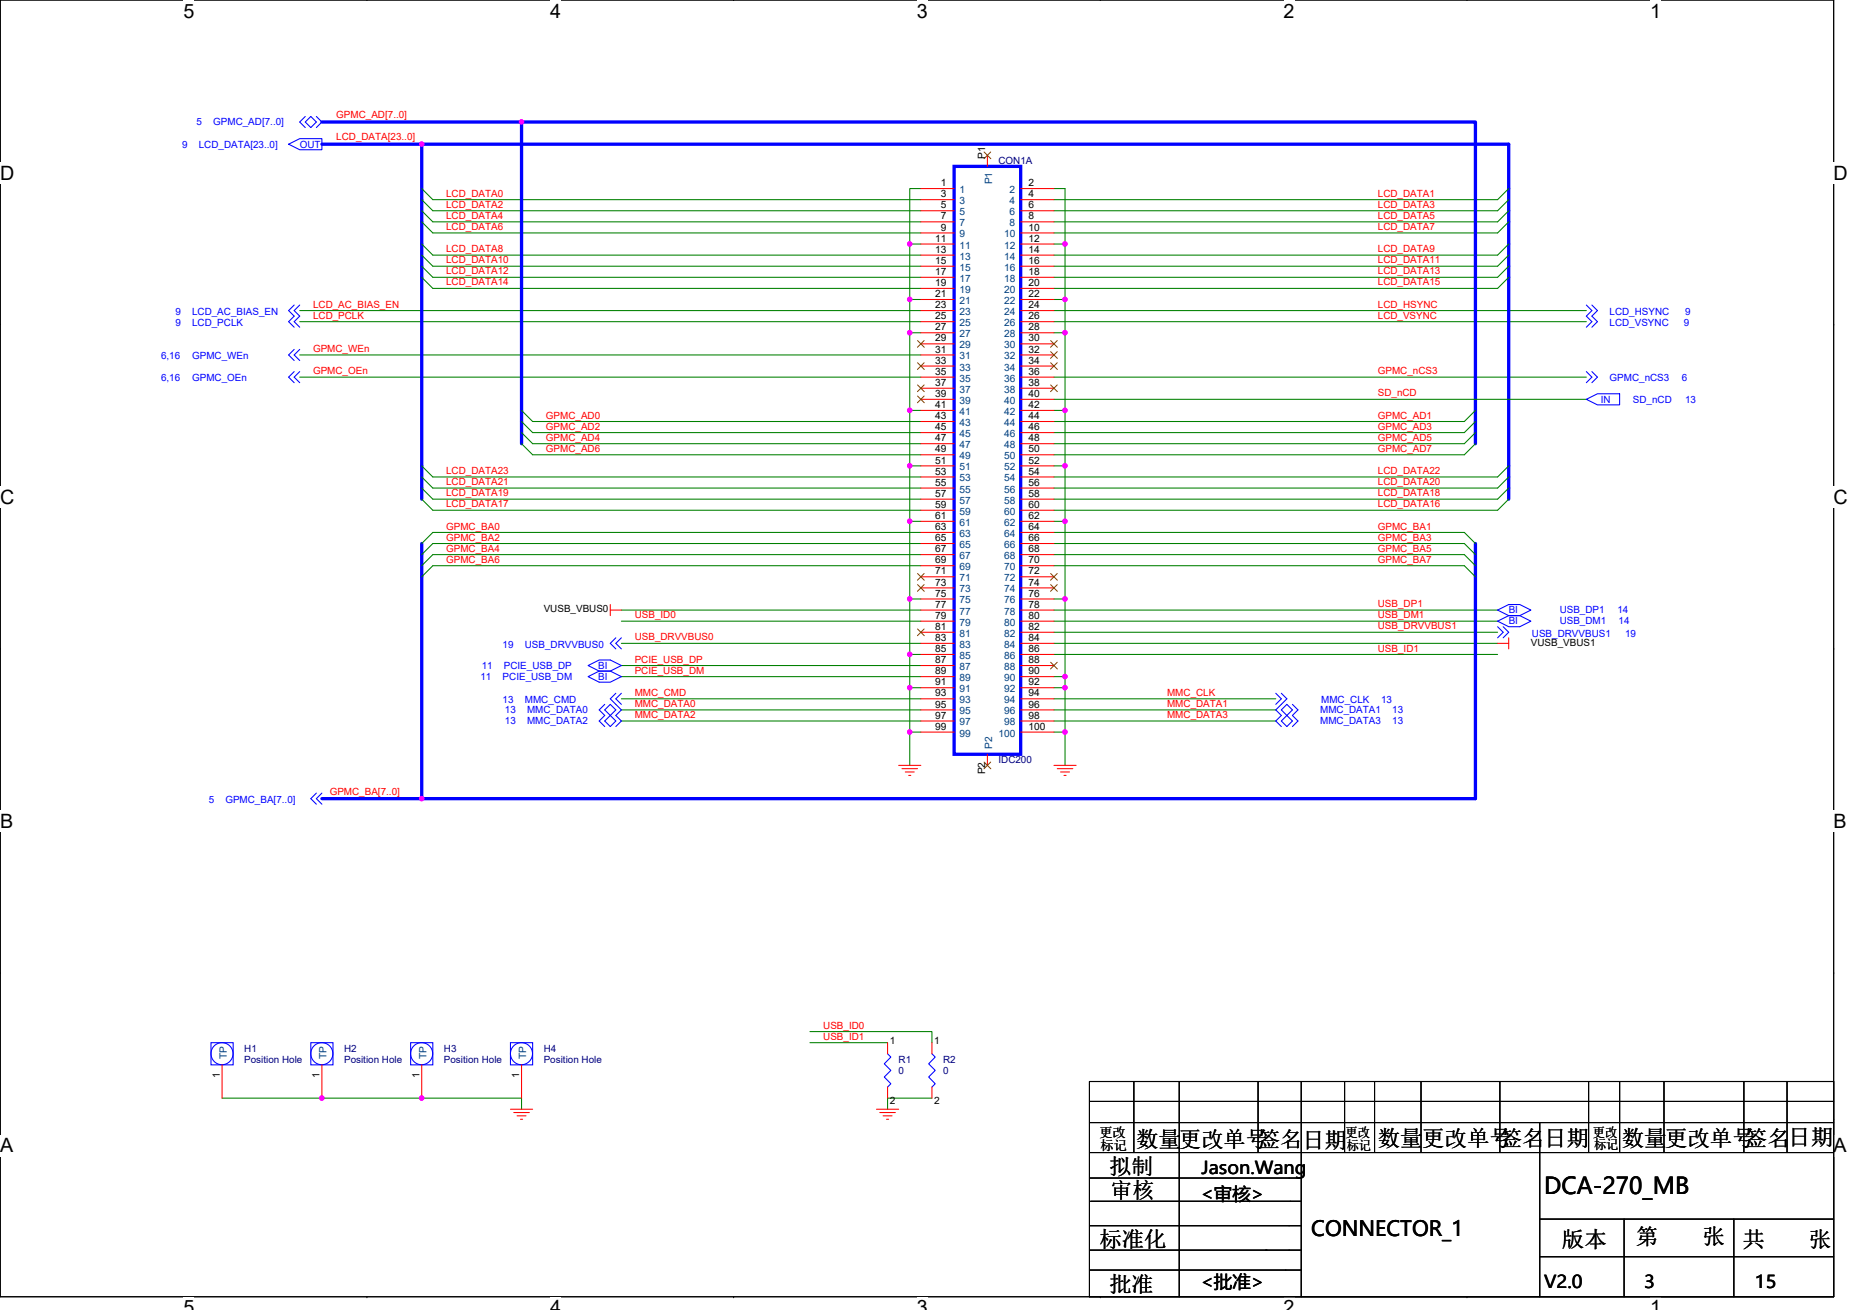
[picture p22: page 3]
USB_ID1; USB_ID0; LCD_DATA0 LCD_DATA2 LCD_DATA4 LCD_DATA6; LCD_DATA8 LCD_DATA10 LCD_DATA12 LCD_DATA14; LCD_DATA9 LCD_DATA11 LCD_DATA13 LCD_DATA15; LCD_DATA1 LCD_DATA3 LCD_DATA5 LCD_DATA7; LCD_DATA[23..0]; LCD_PCLK; LCD_AC_BIAS_EN; LCD_HSYNC; LCD_VSYNC; GPMC_WEn; GPMC_OEn; GPMC_nCS3; GPMC_AD0 GPMC_AD2 GPMC_AD4 GPMC_AD6; LCD_DATA23 LCD_DATA21 LCD_DATA19 LCD_DATA17; GPMC_AD1 GPMC_AD3 GPMC_AD5; LCD_DATA20 LCD_DATA18 LCD_DATA16; GPMC_AD[7..0]; USB_DRVVBUS0; PCIE_USB_DP PCIE_USB_DM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

SD_nCD

GPMC_AD7 LCD_DATA22

79 79 81 81 83 83 85 85 | USB_DM1

USB_DRVVBUS1

Position Hole TP

标记 标记 标记 | 数量更改单号签名日期 更改 数量更改单号签名日期 更改 数量更改单号签名日期 更改 | | | 更改 更改 更改 标记 标记 标记 | 数量更改单号 数量更改单号 数量更改单号 | | 签名 签名日期 更改标记 数量更改单号 签名 签名日期 更改标记 数量更改单号 签名 签名日期 更改标记 数量更改单号 | 日期 日期 日期
拟制 拟制 拟制 | | Jason.Wang Jason.Wang Jason.Wang | CONNECTOR_1 CONNECTOR_1 CONNECTOR_1 | | | DCA-270_MB DCA-270_MB DCA-270_MB
审核 审核 审核 | | <审核> <审核> <审核>

D | D
注意：

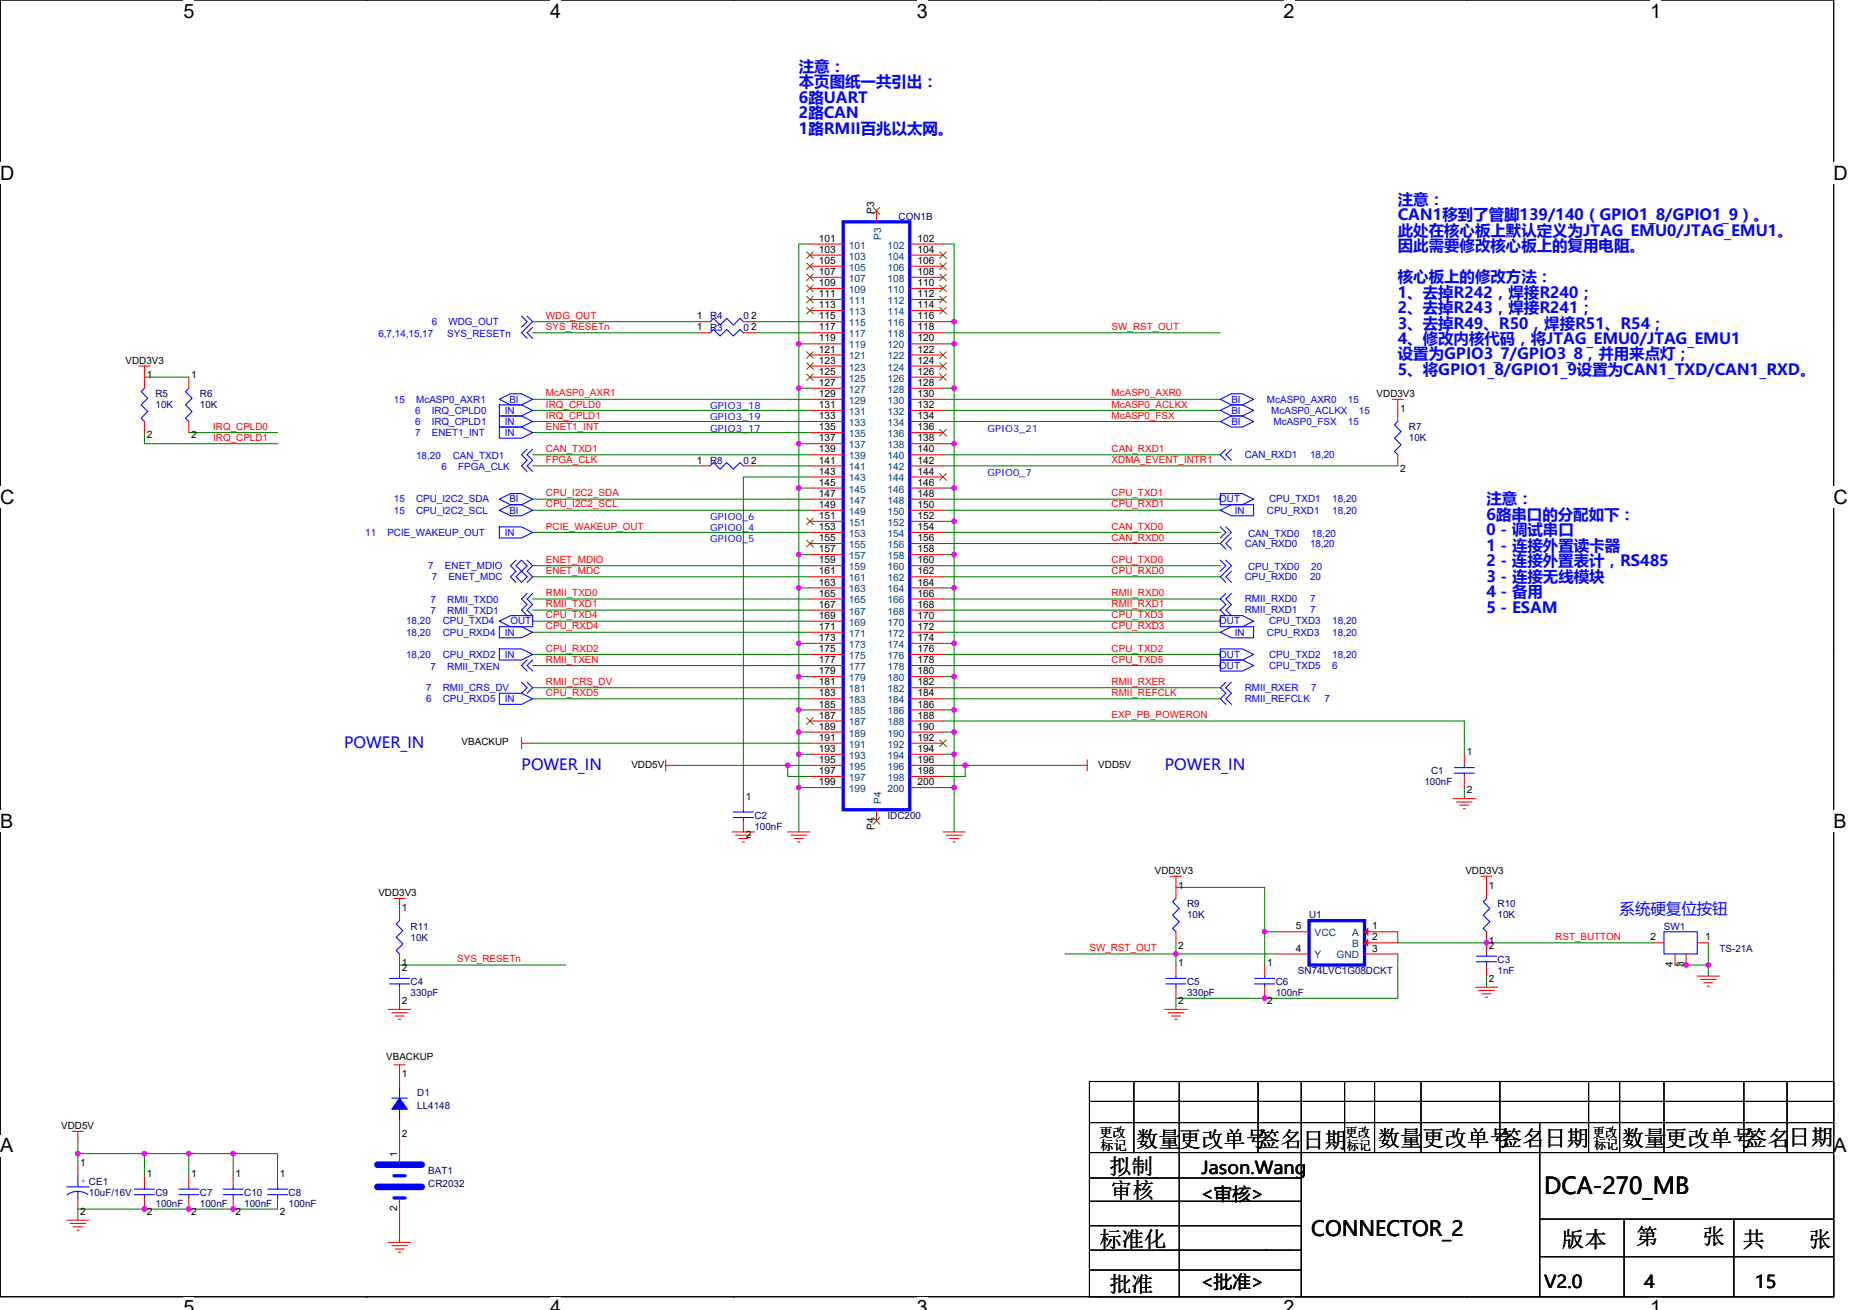
[picture p23: page 4]

D | D

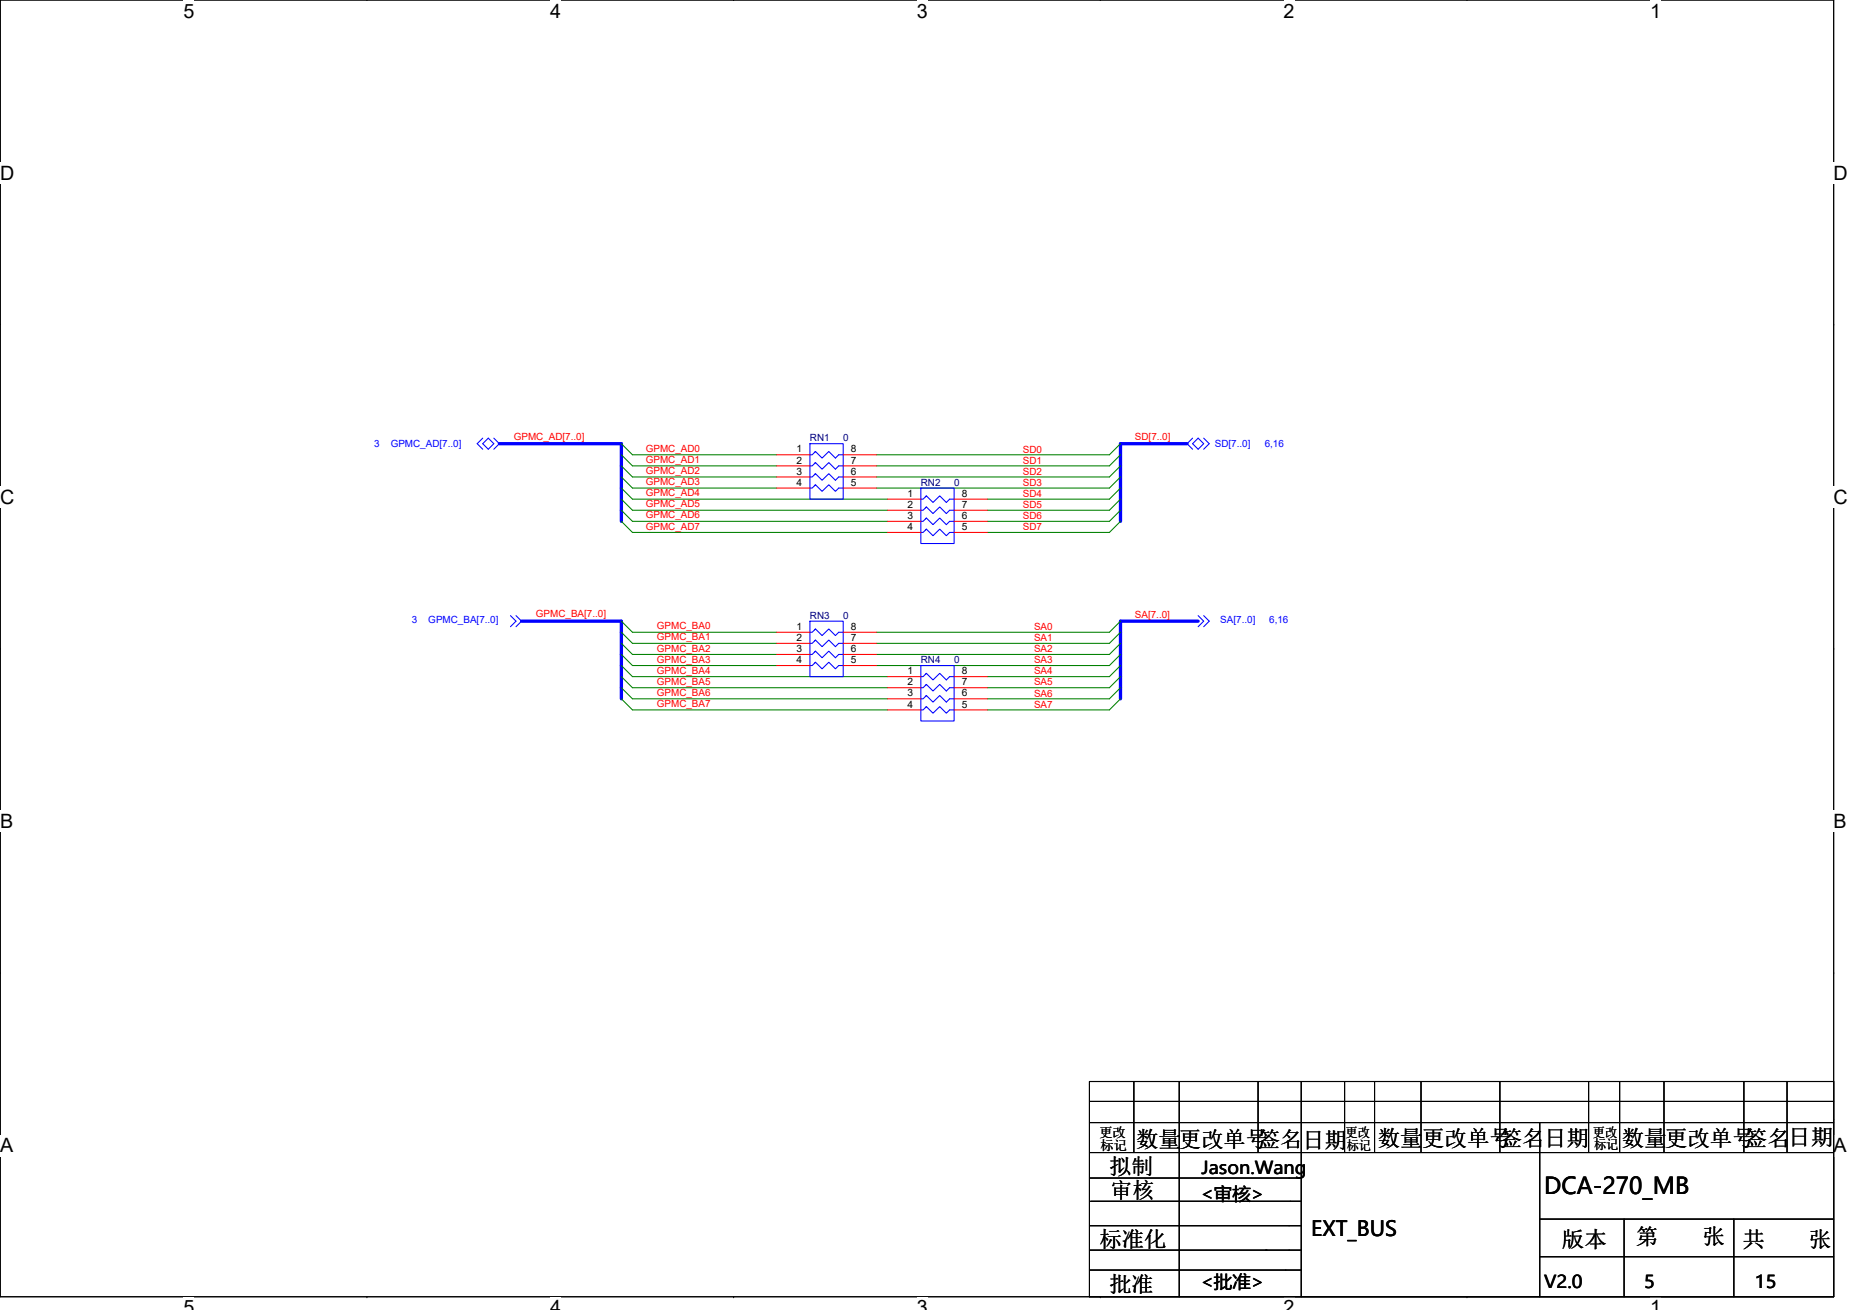
[picture p24: page 5]
GPMC_BA[7..0]; GPMC_BA0 GPMC_BA1 GPMC_BA2 GPMC_BA3 GPMC_BA4 GPMC_BA5 GPMC_BA6 GPMC_BA7; GPMC_AD0 GPMC_AD1 GPMC_AD2 GPMC_AD3 GPMC_AD4 GPMC_AD5 GPMC_AD6 GPMC_AD7; GPMC_AD[7..0]; 3 GPMC_BA[7..0]; 3 GPMC_AD[7..0]

标记 标记 标记 | 数量更改单号签名日期 更改 数量更改单号签名日期 更改 数量更改单号签名日期 更改 | | | 更改 更改 更改 标记 标记 标记 | 数量更改单号 数量更改单号 数量更改单号 | | 签名 签名日期 更改标记 数量更改单号 签名 签名日期 更改标记 数量更改单号 签名 签名日期 更改标记 数量更改单号 | 日期 日期 日期
拟制 拟制 拟制 | | Jason.Wang Jason.Wang Jason.Wang | EXT_BUS EXT_BUS EXT_BUS | | | DCA-270_MB DCA-270_MB DCA-270_MB
审核 审核 审核 | | <审核> <审核> <审核>

D | D

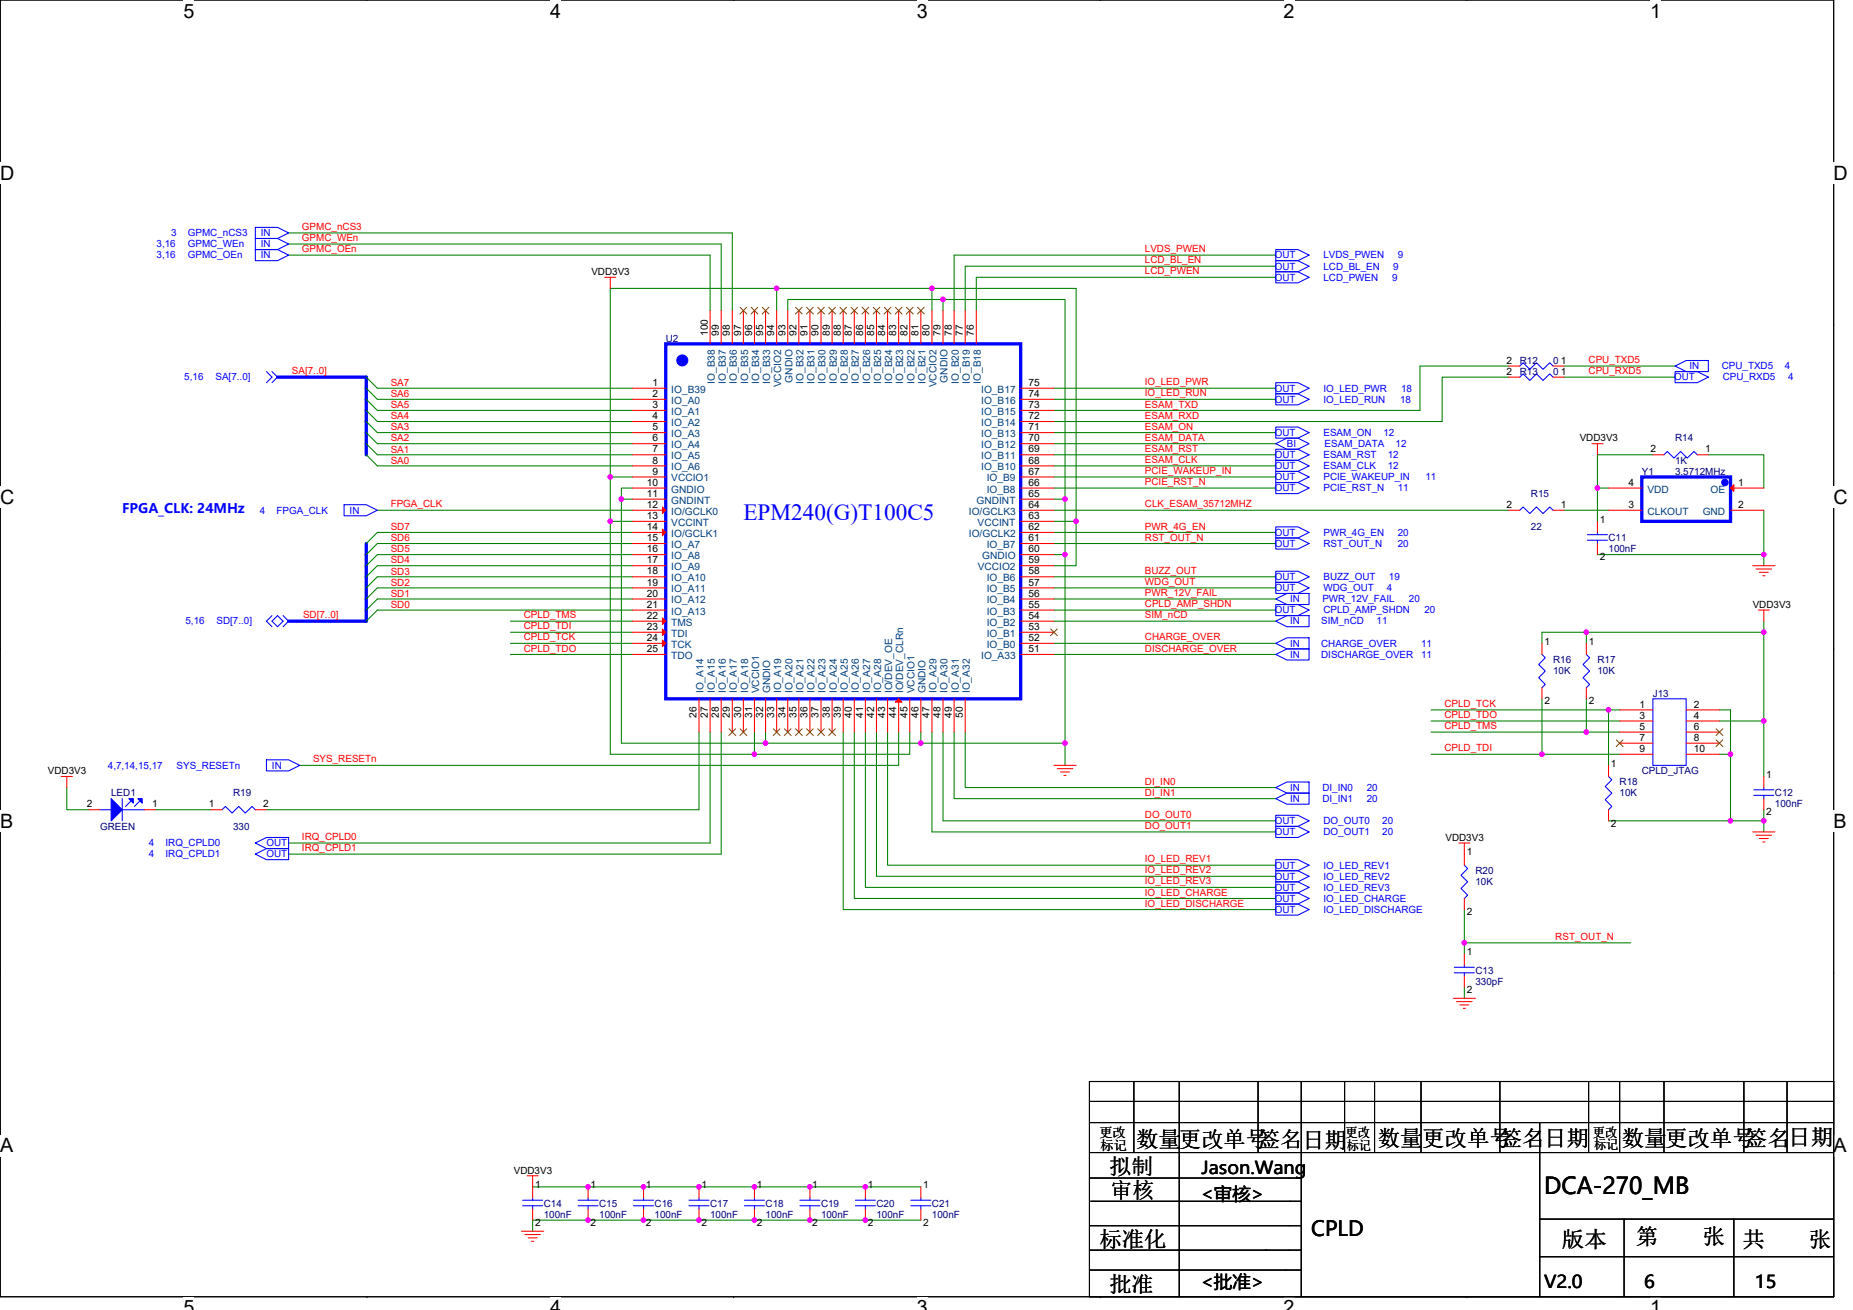
[picture p25: page 6]

IO_A32 50 IO_A33 51 IO_B0 52 IO_B1 53 IO_B2 54 IO_B3 55 IO_B4 56 IO_B5 57 IO_B6 58 VCCIO2 59 GNDIO 60 IO_B7 61 IO/GCLK2 62 VCCINT 63 IO/GCLK3 64 GNDINT 65 IO_B8 66 IO_B9 67 IO_B10 68 IO_B11 69 IO_B12 70 IO_B13 71 IO_B14 72 IO_B15 73 IO_B16 74 IO_B17

标记 标记 标记 | 数量更改单号签名日期 更改 数量更改单号签名日期 更改 数量更改单号签名日期 更改 | | | 更改 更改 更改 标记 标记 标记 | 数量更改单号 数量更改单号 数量更改单号 | | 签名 签名日期 更改标记 数量更改单号 签名 签名日期 更改标记 数量更改单号 签名 签名日期 更改标记 数量更改单号 | 日期 日期 日期
拟制 拟制 拟制 | | Jason.Wang Jason.Wang Jason.Wang | CPLD CPLD CPLD | | | DCA-270_MB DCA-270_MB DCA-270_MB
审核 审核 审核 | | <审核> <审核> <审核>

D | D

## Enable Far-End Fault

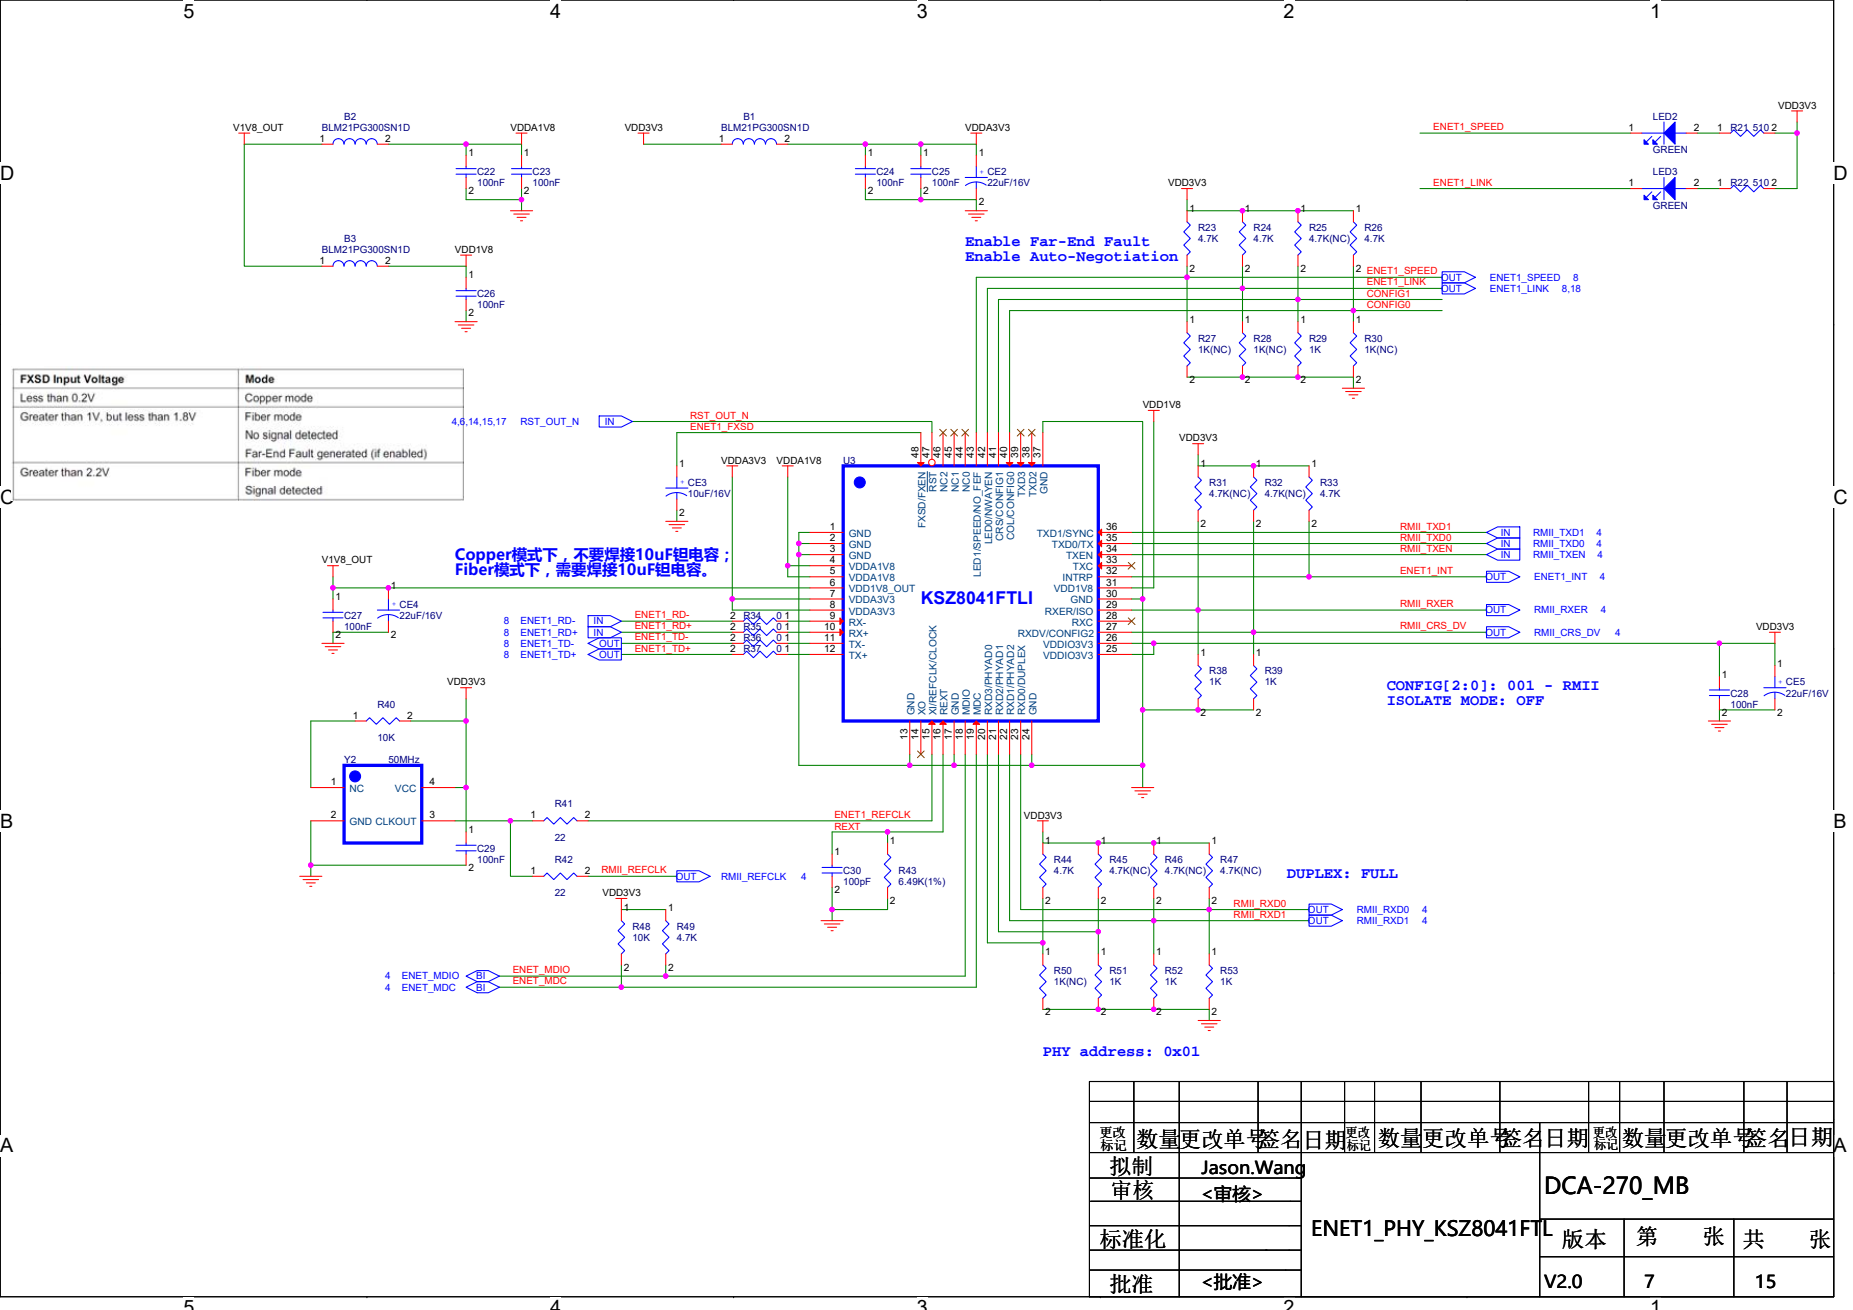
[picture p26: page 7]

标记 标记 标记 | 数量更改单号签名日期 更改 数量更改单号签名日期 更改 数量更改单号签名日期 更改 | | 更改 更改 更改 标记 标记 标记 | 数量更改单号 数量更改单号 数量更改单号 | | 签名 签名日期 更改标记 数量更改单号 签名 签名日期 更改标记 数量更改单号 签名 签名日期 更改标记 数量更改单号 | 日期 日期 日期
拟制 拟制 拟制 | | Jason.Wang Jason.Wang Jason.Wang | | | DCA-270_MB DCA-270_MB DCA-270_MB
审核 审核 审核 | | <审核> <审核> <审核>

D | D

注意：

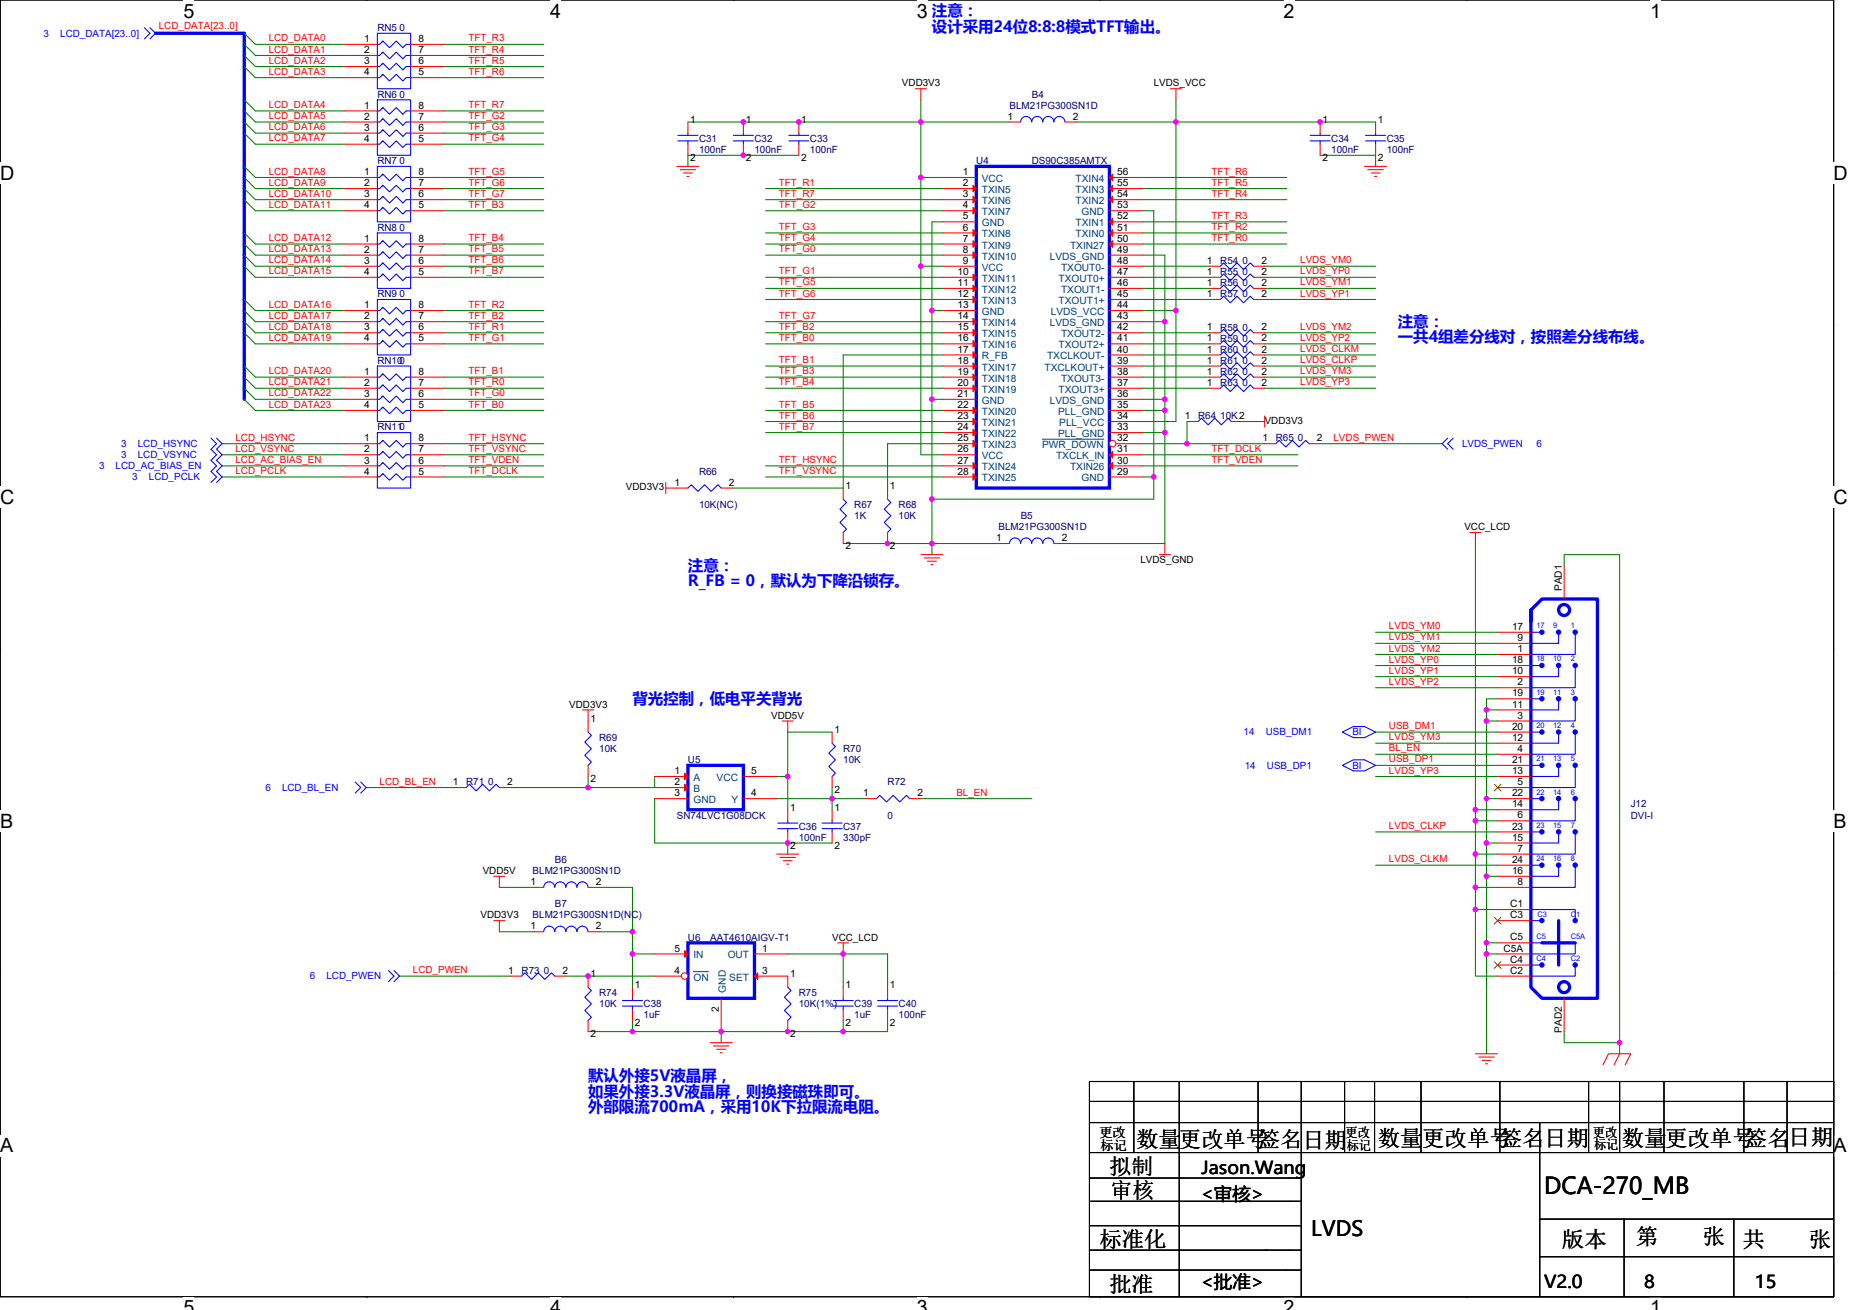
[picture p27: page 8]

标记 标记 标记 | 数量更改单号签名日期 更改 数量更改单号签名日期 更改 数量更改单号签名日期 更改 | | | 更改 更改 更改 标记 标记 标记 | 数量更改单号 数量更改单号 数量更改单号 | | 签名 签名日期 更改标记 数量更改单号 签名 签名日期 更改标记 数量更改单号 签名 签名日期 更改标记 数量更改单号 | 日期 日期 日期
拟制 拟制 拟制 | | Jason.Wang Jason.Wang Jason.Wang | LVDS LVDS LVDS | | | DCA-270_MB DCA-270_MB DCA-270_MB
审核 审核 审核 | | <审核> <审核> <审核>

D | D

## 选择 MINI PCIE插座时，要求高度较高

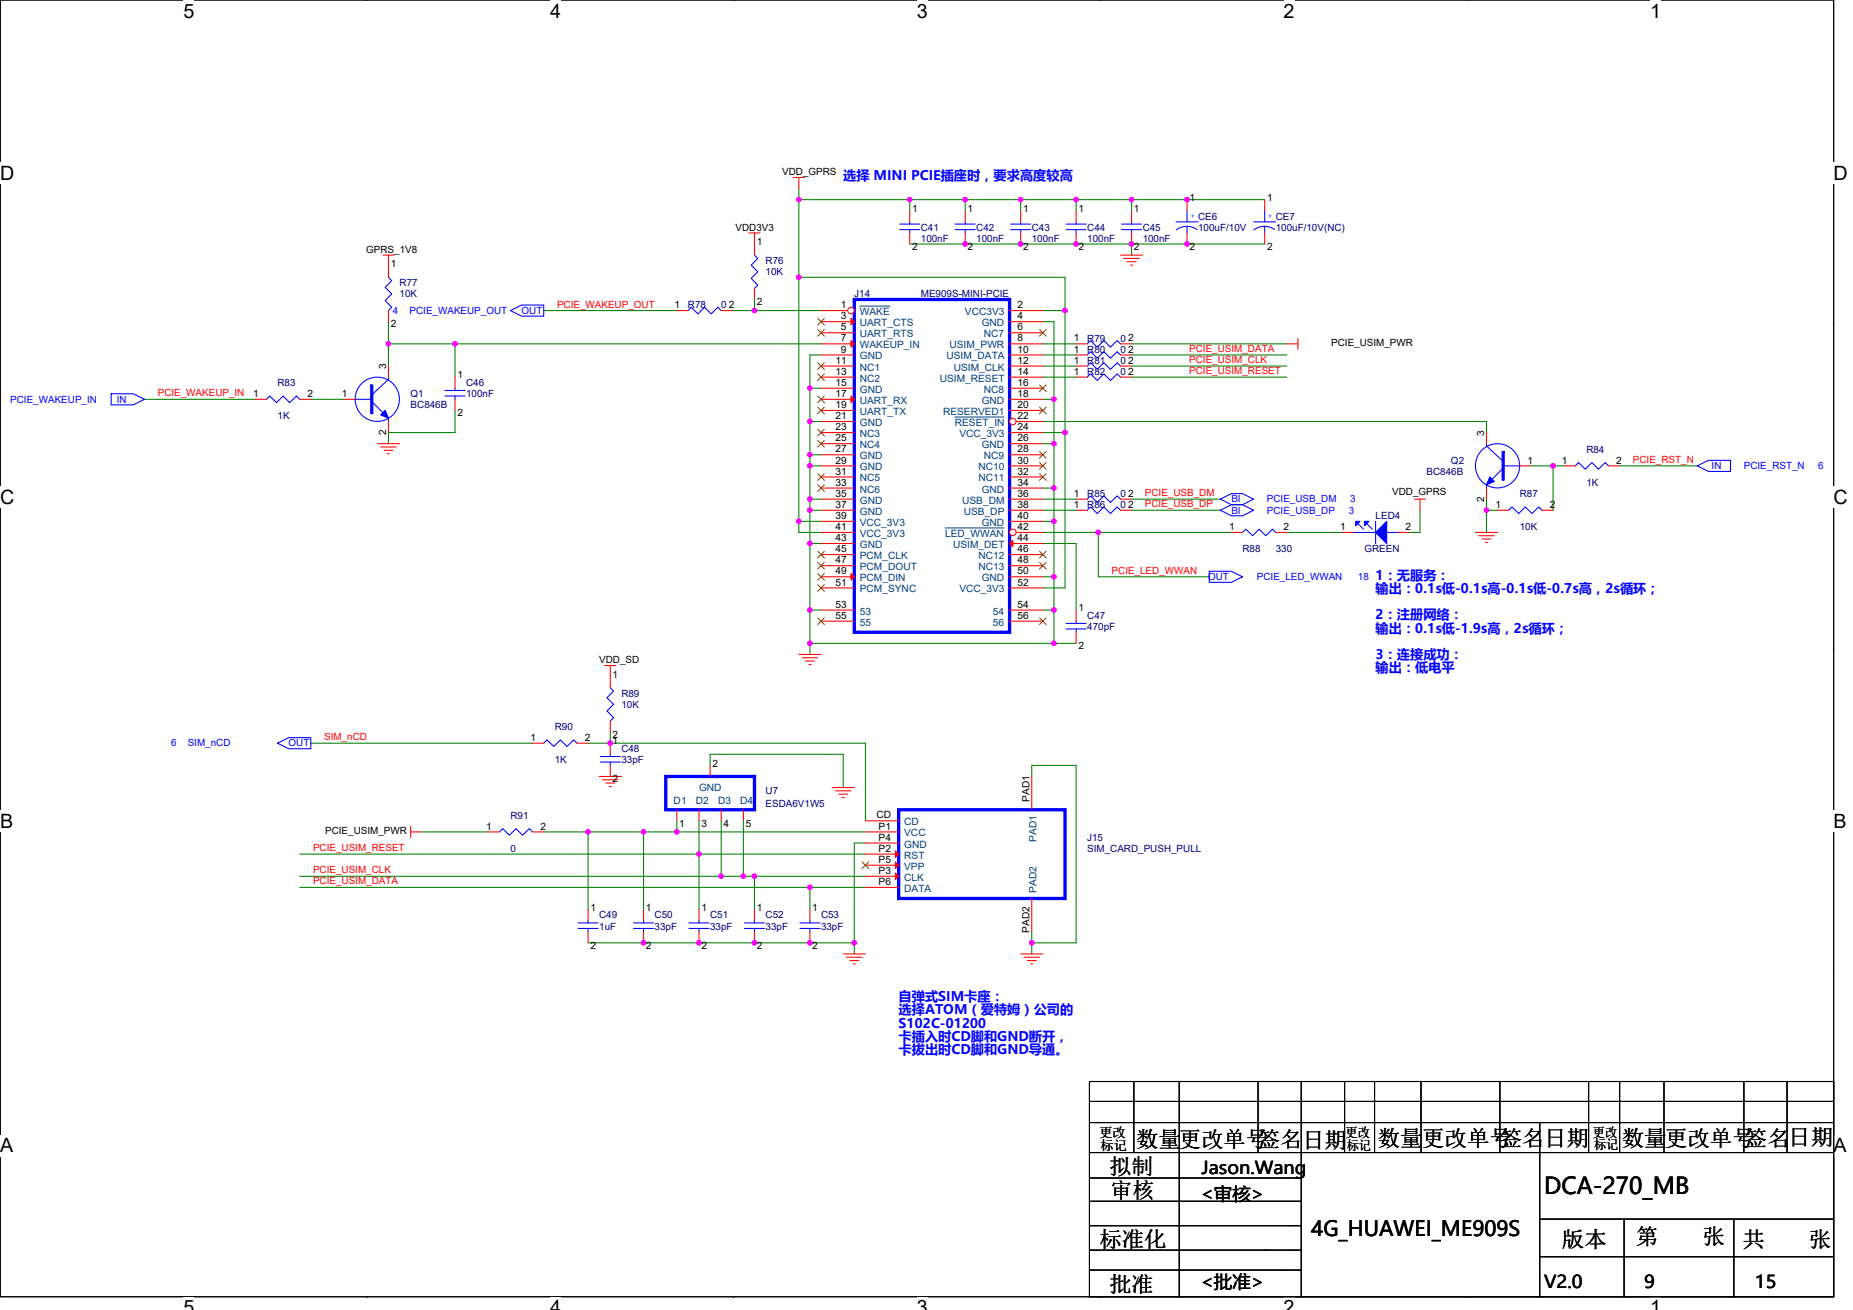
[picture p28: page 9]

标记 标记 标记 | 数量更改单号签名日期 更改 数量更改单号签名日期 更改 数量更改单号签名日期 更改 | | | 更改 更改 更改 标记 标记 标记 | 数量更改单号 数量更改单号 数量更改单号 | | 签名 签名日期 更改标记 数量更改单号 签名 签名日期 更改标记 数量更改单号 签名 签名日期 更改标记 数量更改单号 | 日期 日期 日期
拟制 拟制 拟制 | | Jason.Wang Jason.Wang Jason.Wang | 4G_HUAWEI_ME909S 4G_HUAWEI_ME909S 4G_HUAWEI_ME909S | | | DCA-270_MB DCA-270_MB DCA-270_MB
审核 审核 审核 | | <审核> <审核> <审核>

D | D

注意：

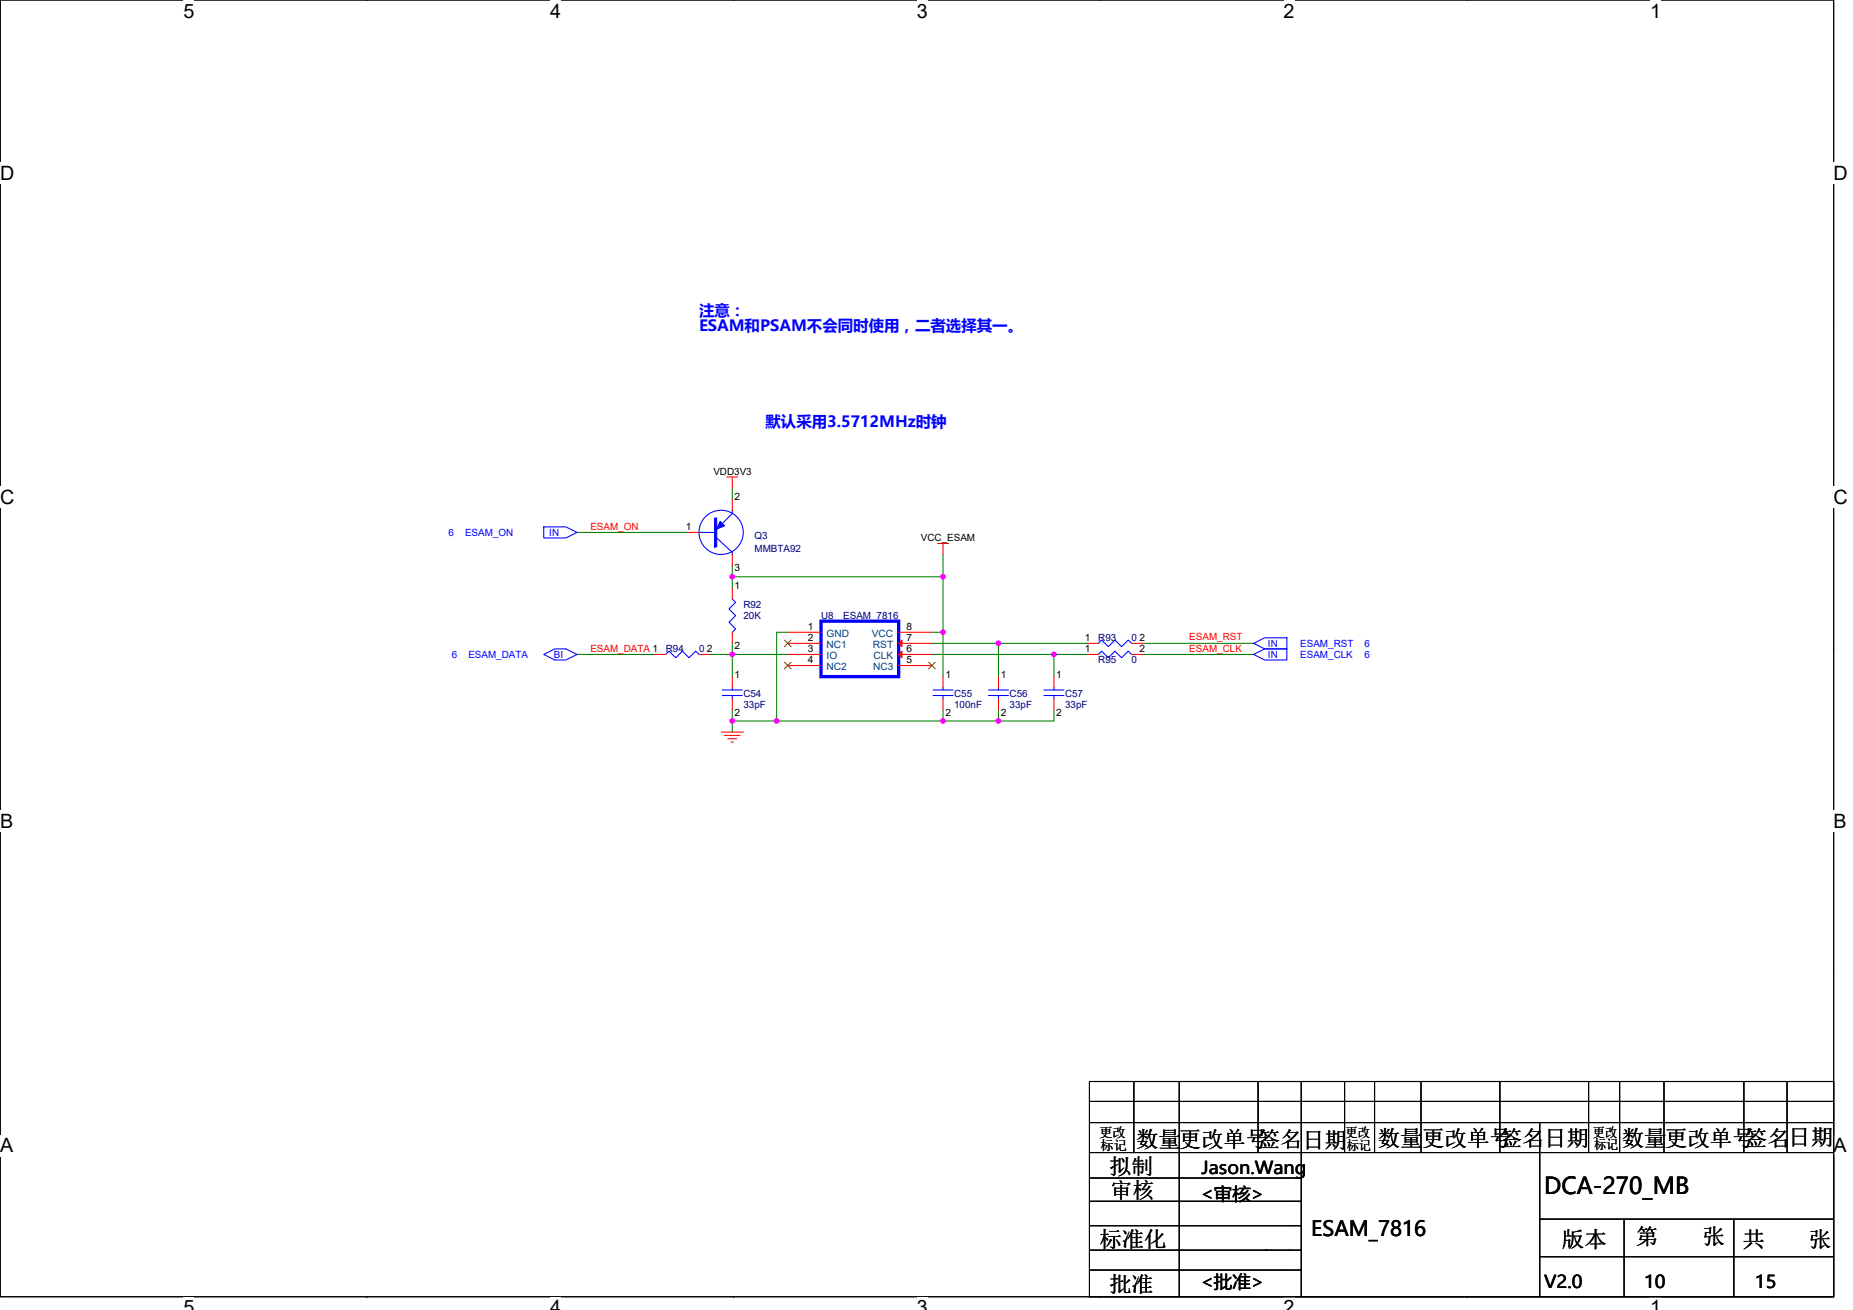
[picture p29: page 10]

标记 标记 标记 | 数量更改单号签名日期 更改 数量更改单号签名日期 更改 数量更改单号签名日期 更改 | | | 更改 更改 更改 标记 标记 标记 | 数量更改单号 数量更改单号 数量更改单号 | | 签名 签名日期 更改标记 数量更改单号 签名 签名日期 更改标记 数量更改单号 签名 签名日期 更改标记 数量更改单号 | 日期 日期 日期
拟制 拟制 拟制 | | Jason.Wang Jason.Wang Jason.Wang | ESAM_7816 ESAM_7816 ESAM_7816 | | | DCA-270_MB DCA-270_MB DCA-270_MB
审核 审核 审核 | | <审核> <审核> <审核>

D | D

说明：

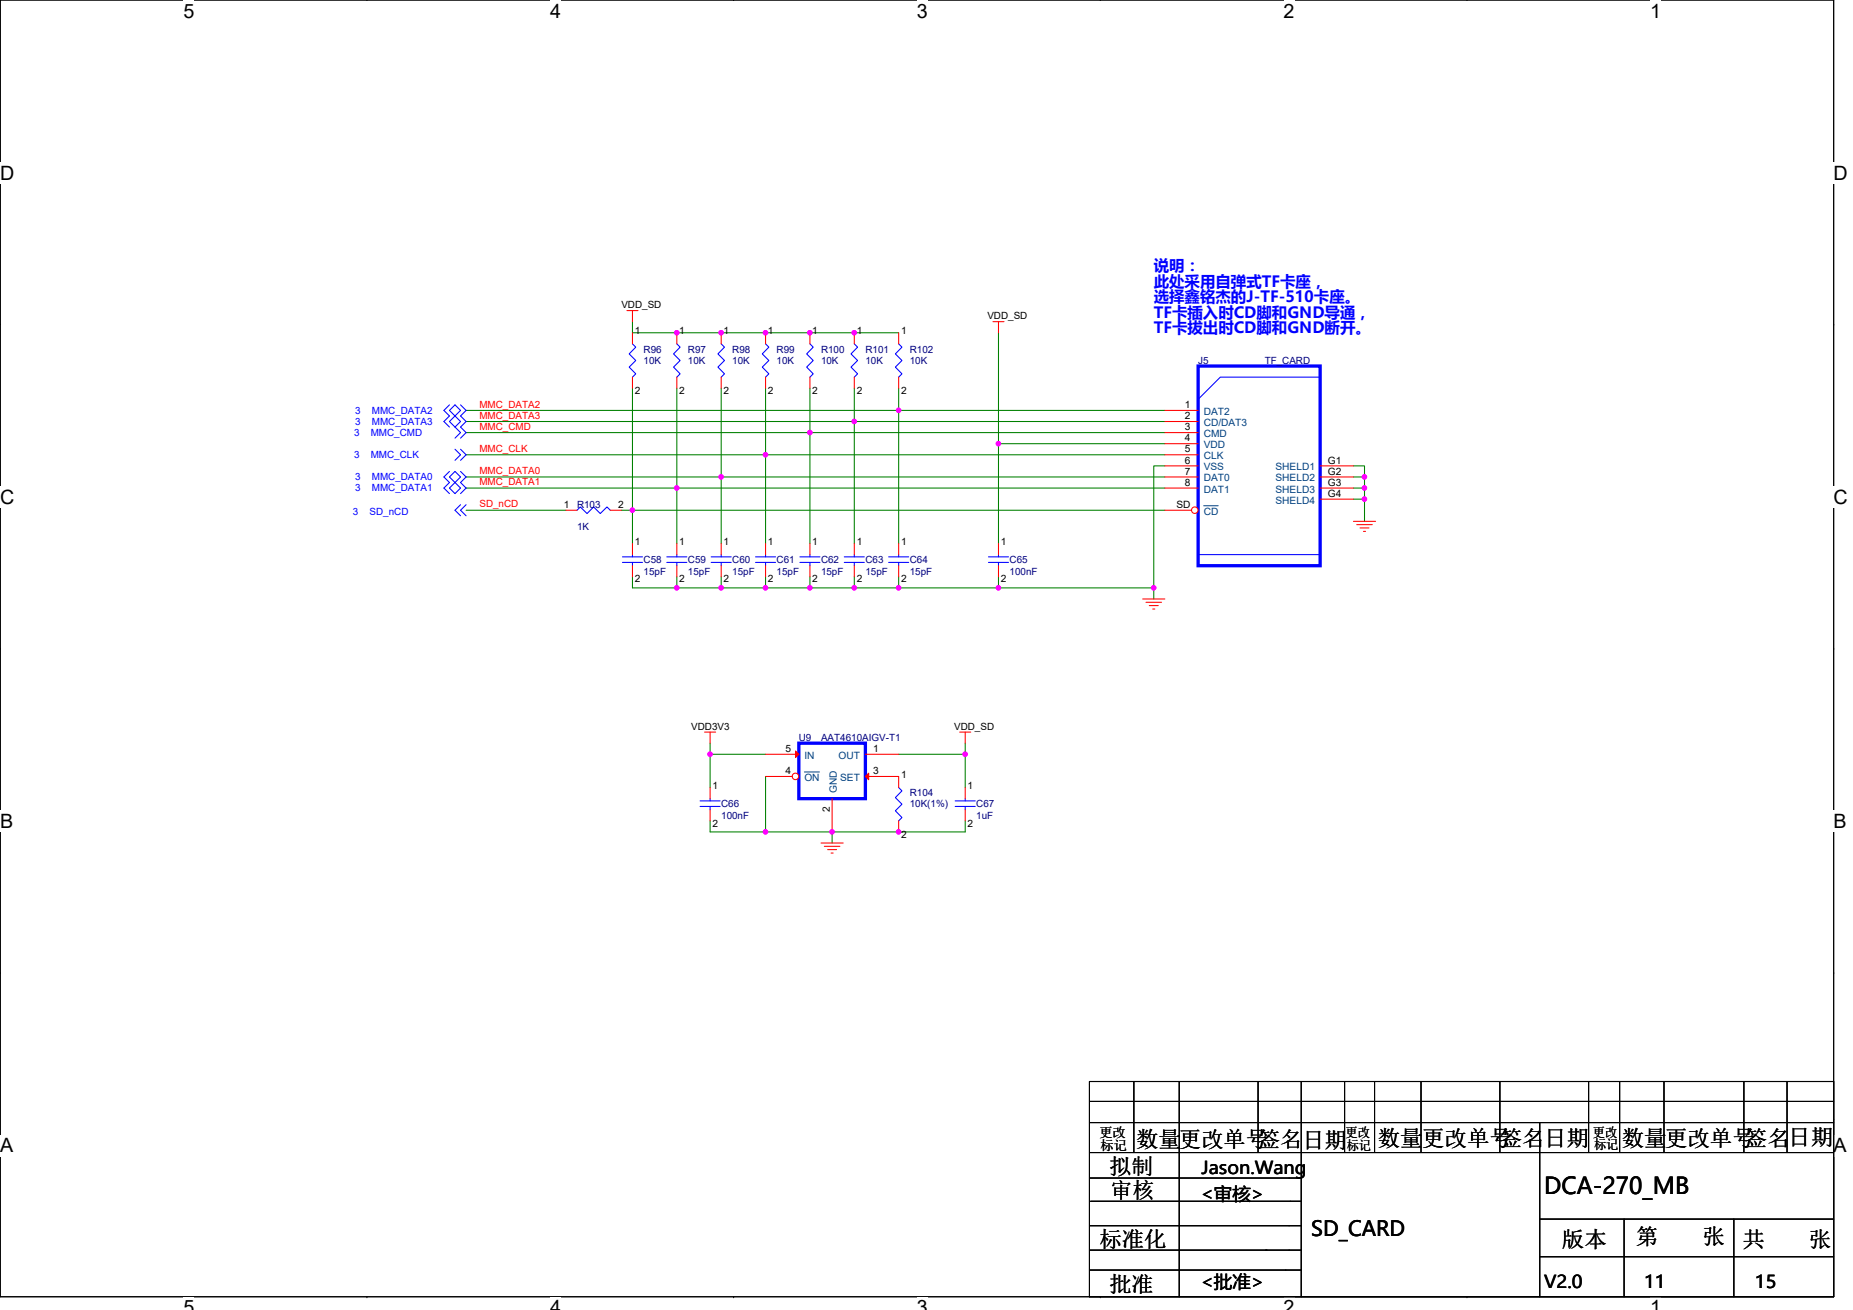
[picture p30: page 11]

标记 标记 标记 | 数量更改单号签名日期 更改 数量更改单号签名日期 更改 数量更改单号签名日期 更改 | | | 更改 更改 更改 标记 标记 标记 | 数量更改单号 数量更改单号 数量更改单号 | | 签名 签名日期 更改标记 数量更改单号 签名 签名日期 更改标记 数量更改单号 签名 签名日期 更改标记 数量更改单号 | 日期 日期 日期
拟制 拟制 拟制 | | Jason.Wang Jason.Wang Jason.Wang | SD_CARD SD_CARD SD_CARD | | | DCA-270_MB DCA-270_MB DCA-270_MB
审核 审核 审核 | | <审核> <审核> <审核>

D | D

# 3.5mm SJ3524

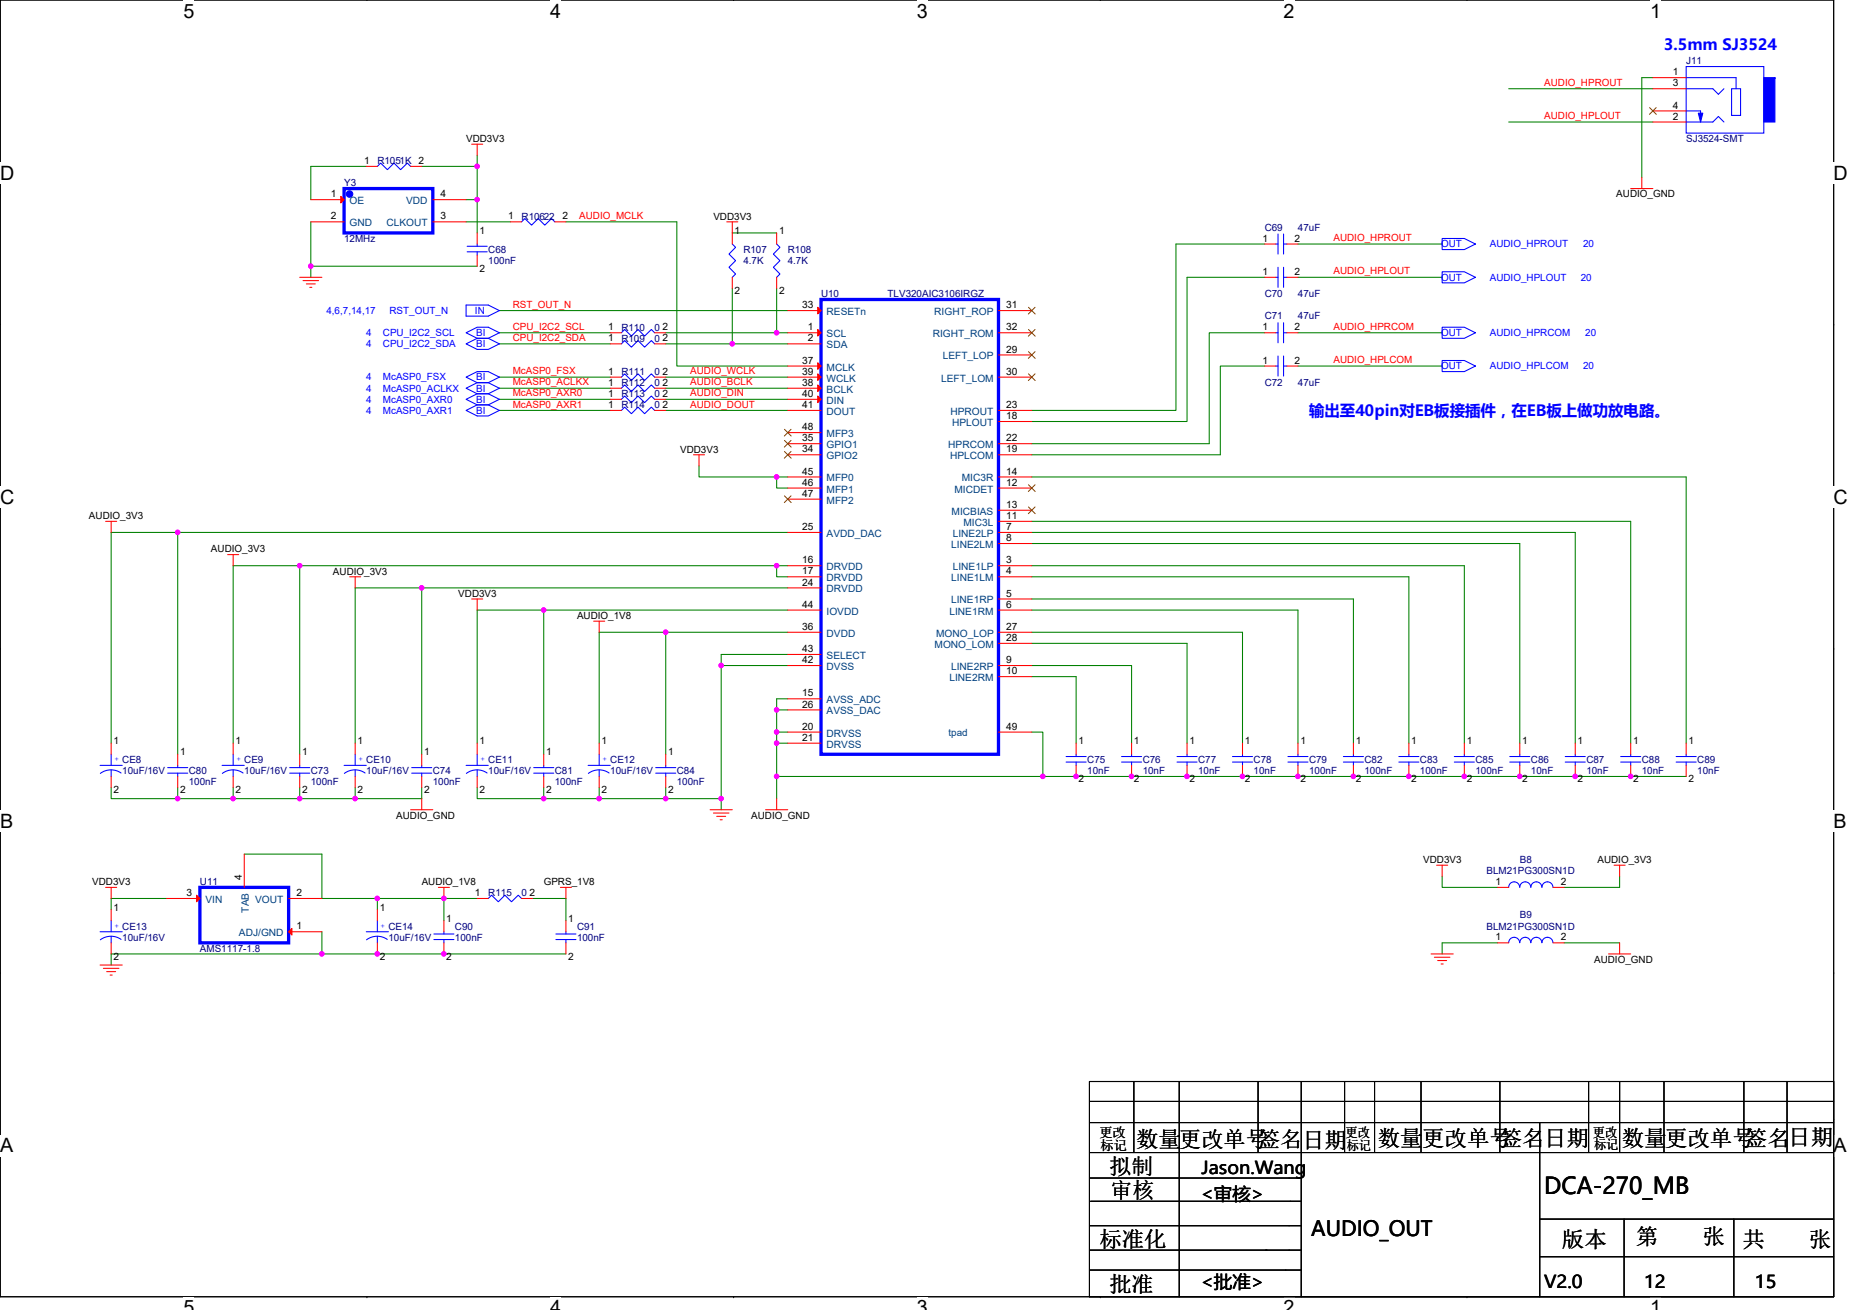
[picture p31: page 12]

标记 标记 标记 | 数量更改单号签名日期 更改 数量更改单号签名日期 更改 数量更改单号签名日期 更改 | | | 更改 更改 更改 标记 标记 标记 | 数量更改单号 数量更改单号 数量更改单号 | | 签名 签名日期 更改标记 数量更改单号 签名 签名日期 更改标记 数量更改单号 签名 签名日期 更改标记 数量更改单号 | 日期 日期 日期
拟制 拟制 拟制 | | Jason.Wang Jason.Wang Jason.Wang | AUDIO_OUT AUDIO_OUT AUDIO_OUT | | | DCA-270_MB DCA-270_MB DCA-270_MB
审核 审核 审核 | | <审核> <审核> <审核>

D | D

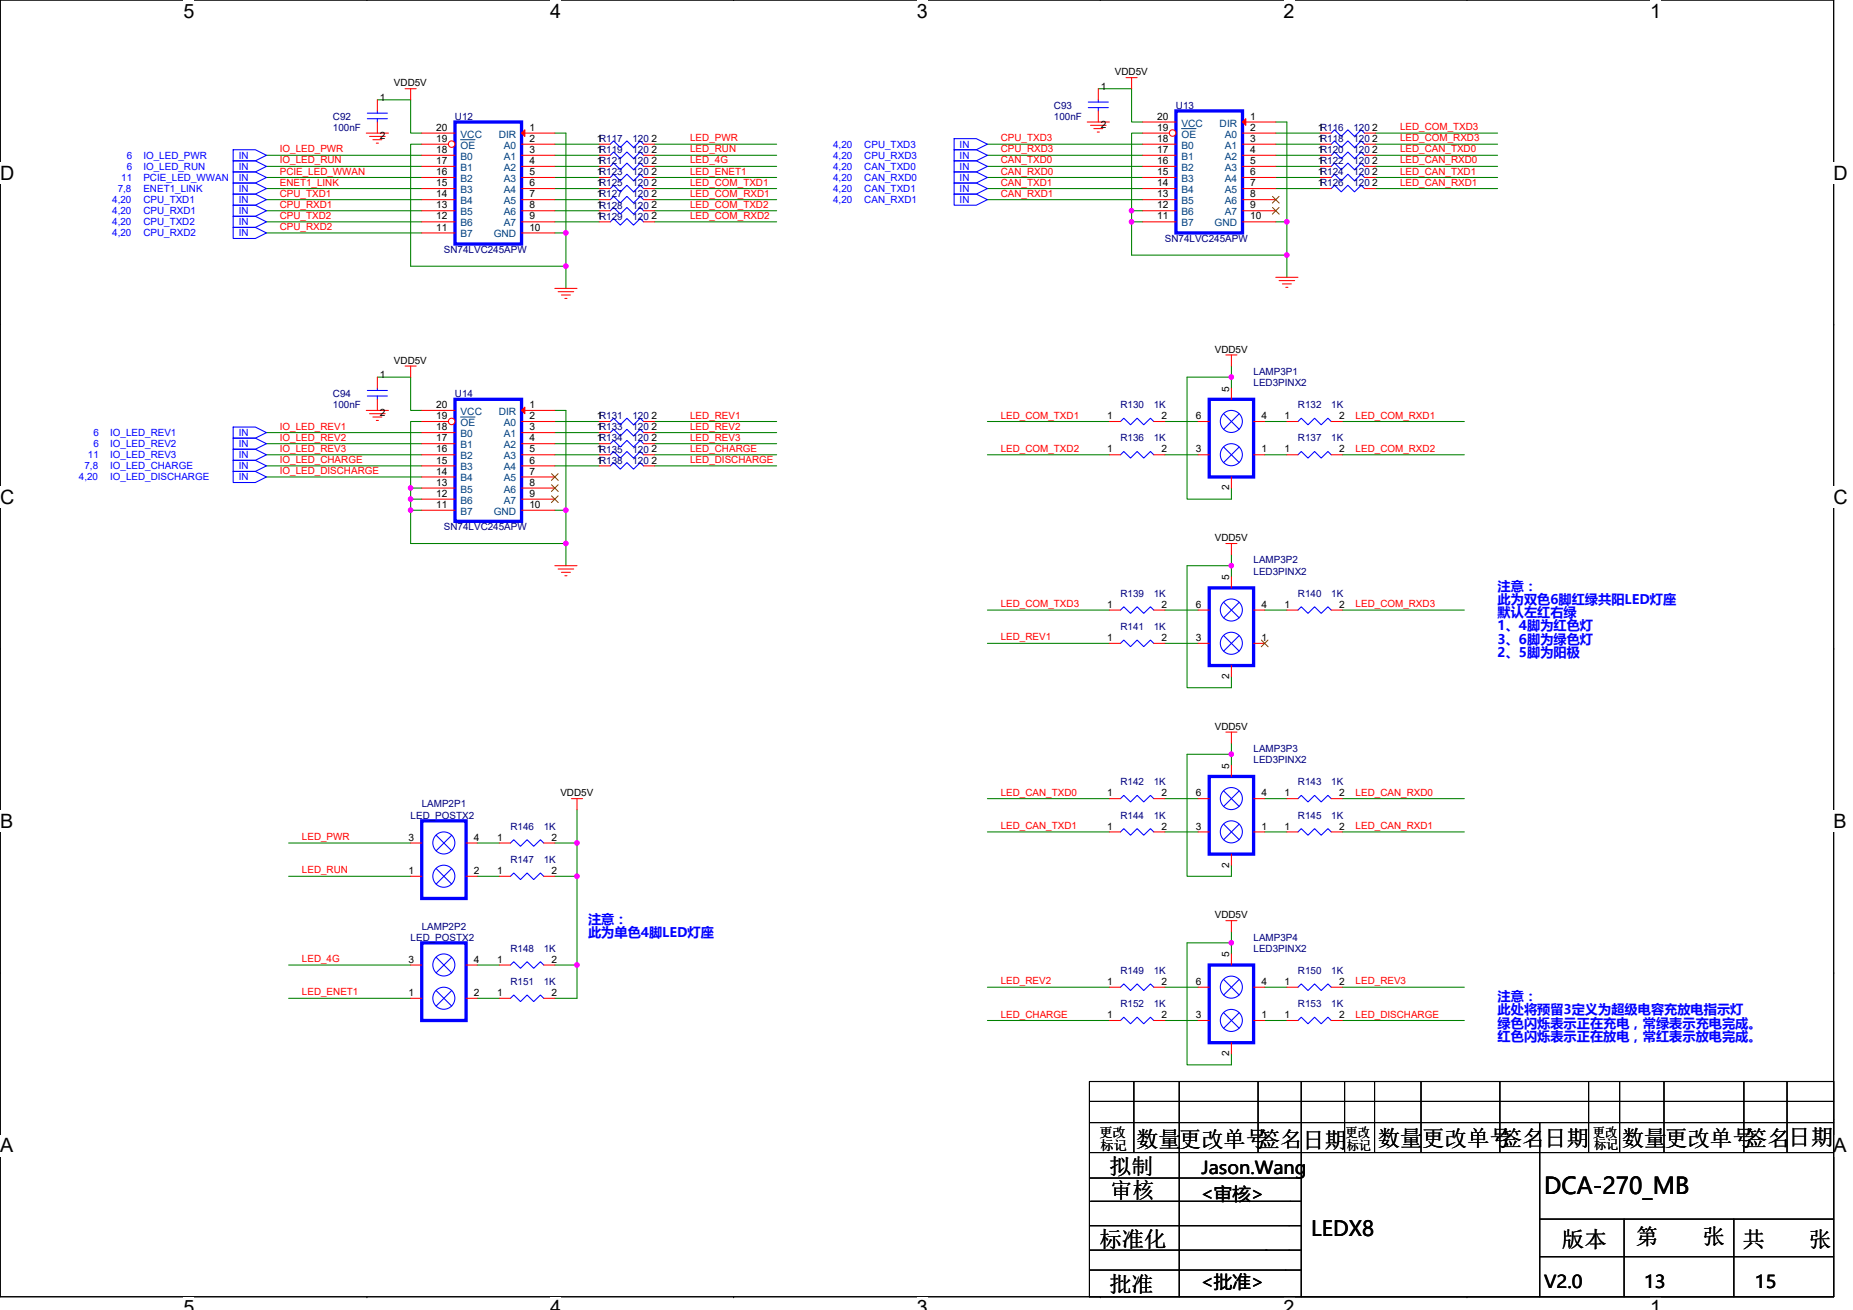
[picture p32: page 13]

标记 标记 标记 | 数量更改单号签名日期 更改 数量更改单号签名日期 更改 数量更改单号签名日期 更改 | | | 更改 更改 更改 标记 标记 标记 | 数量更改单号 数量更改单号 数量更改单号 | | 签名 签名日期 更改标记 数量更改单号 签名 签名日期 更改标记 数量更改单号 签名 签名日期 更改标记 数量更改单号 | 日期 日期 日期
拟制 拟制 拟制 | | Jason.Wang Jason.Wang Jason.Wang | LEDX8 LEDX8 LEDX8 | | | DCA-270_MB DCA-270_MB DCA-270_MB
审核 审核 审核 | | <审核> <审核> <审核>

D | D

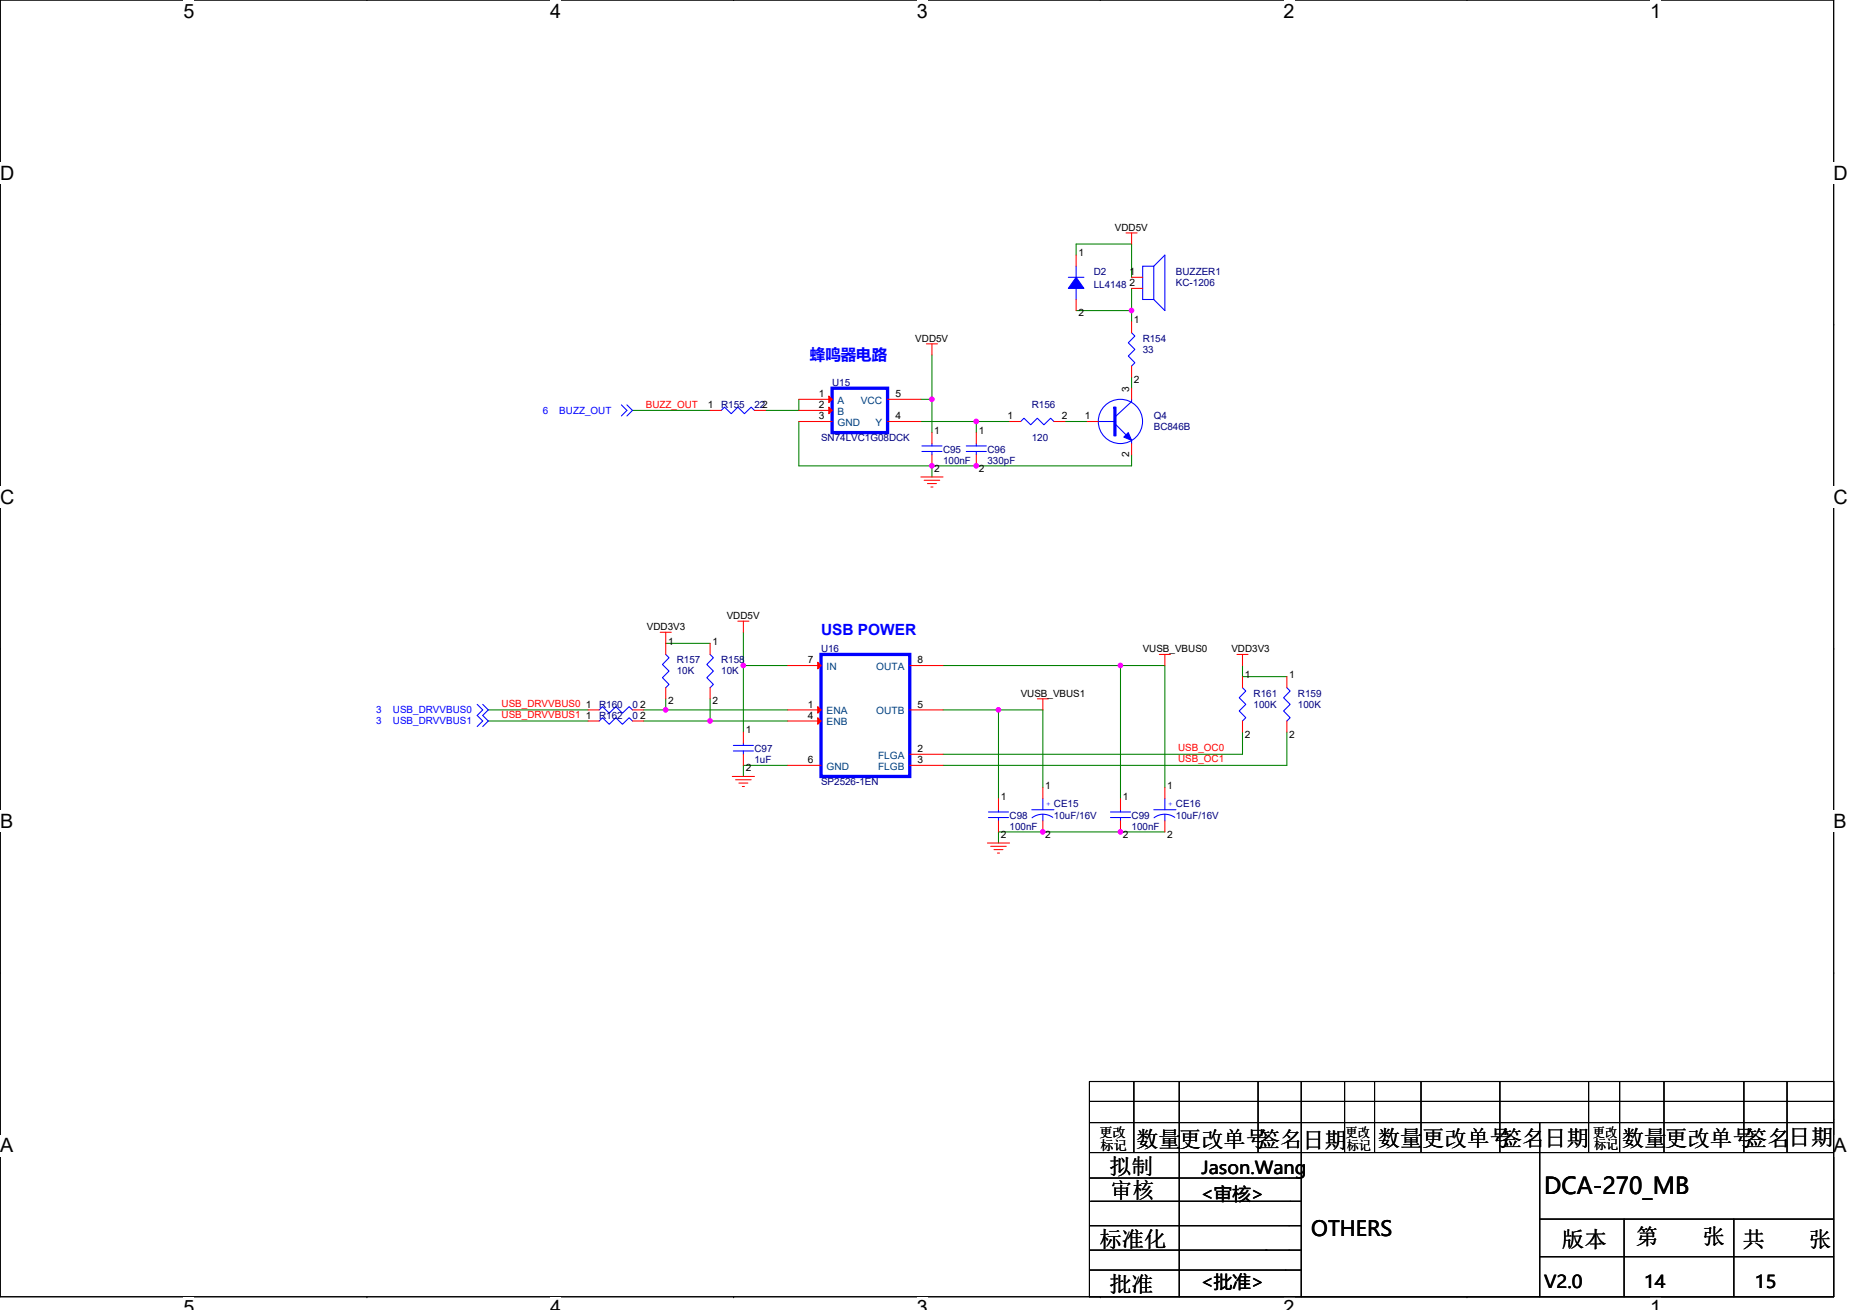
[picture p33: page 14]

C97 | ENA 1 GND 6 | VUSB_VBUS1

USB_OC1

标记 标记 标记 | 数量更改单号签名日期 更改 数量更改单号签名日期 更改 数量更改单号签名日期 更改 | | | 更改 更改 更改 标记 标记 标记 | 数量更改单号 数量更改单号 数量更改单号 | | 签名 签名日期 更改标记 数量更改单号 签名 签名日期 更改标记 数量更改单号 签名 签名日期 更改标记 数量更改单号 | 日期 日期 日期
拟制 拟制 拟制 | | Jason.Wang Jason.Wang Jason.Wang | OTHERS OTHERS OTHERS | | | DCA-270_MB DCA-270_MB DCA-270_MB
审核 审核 审核 | | <审核> <审核> <审核>

注意：

# 该接插件可放置在板子的左边。

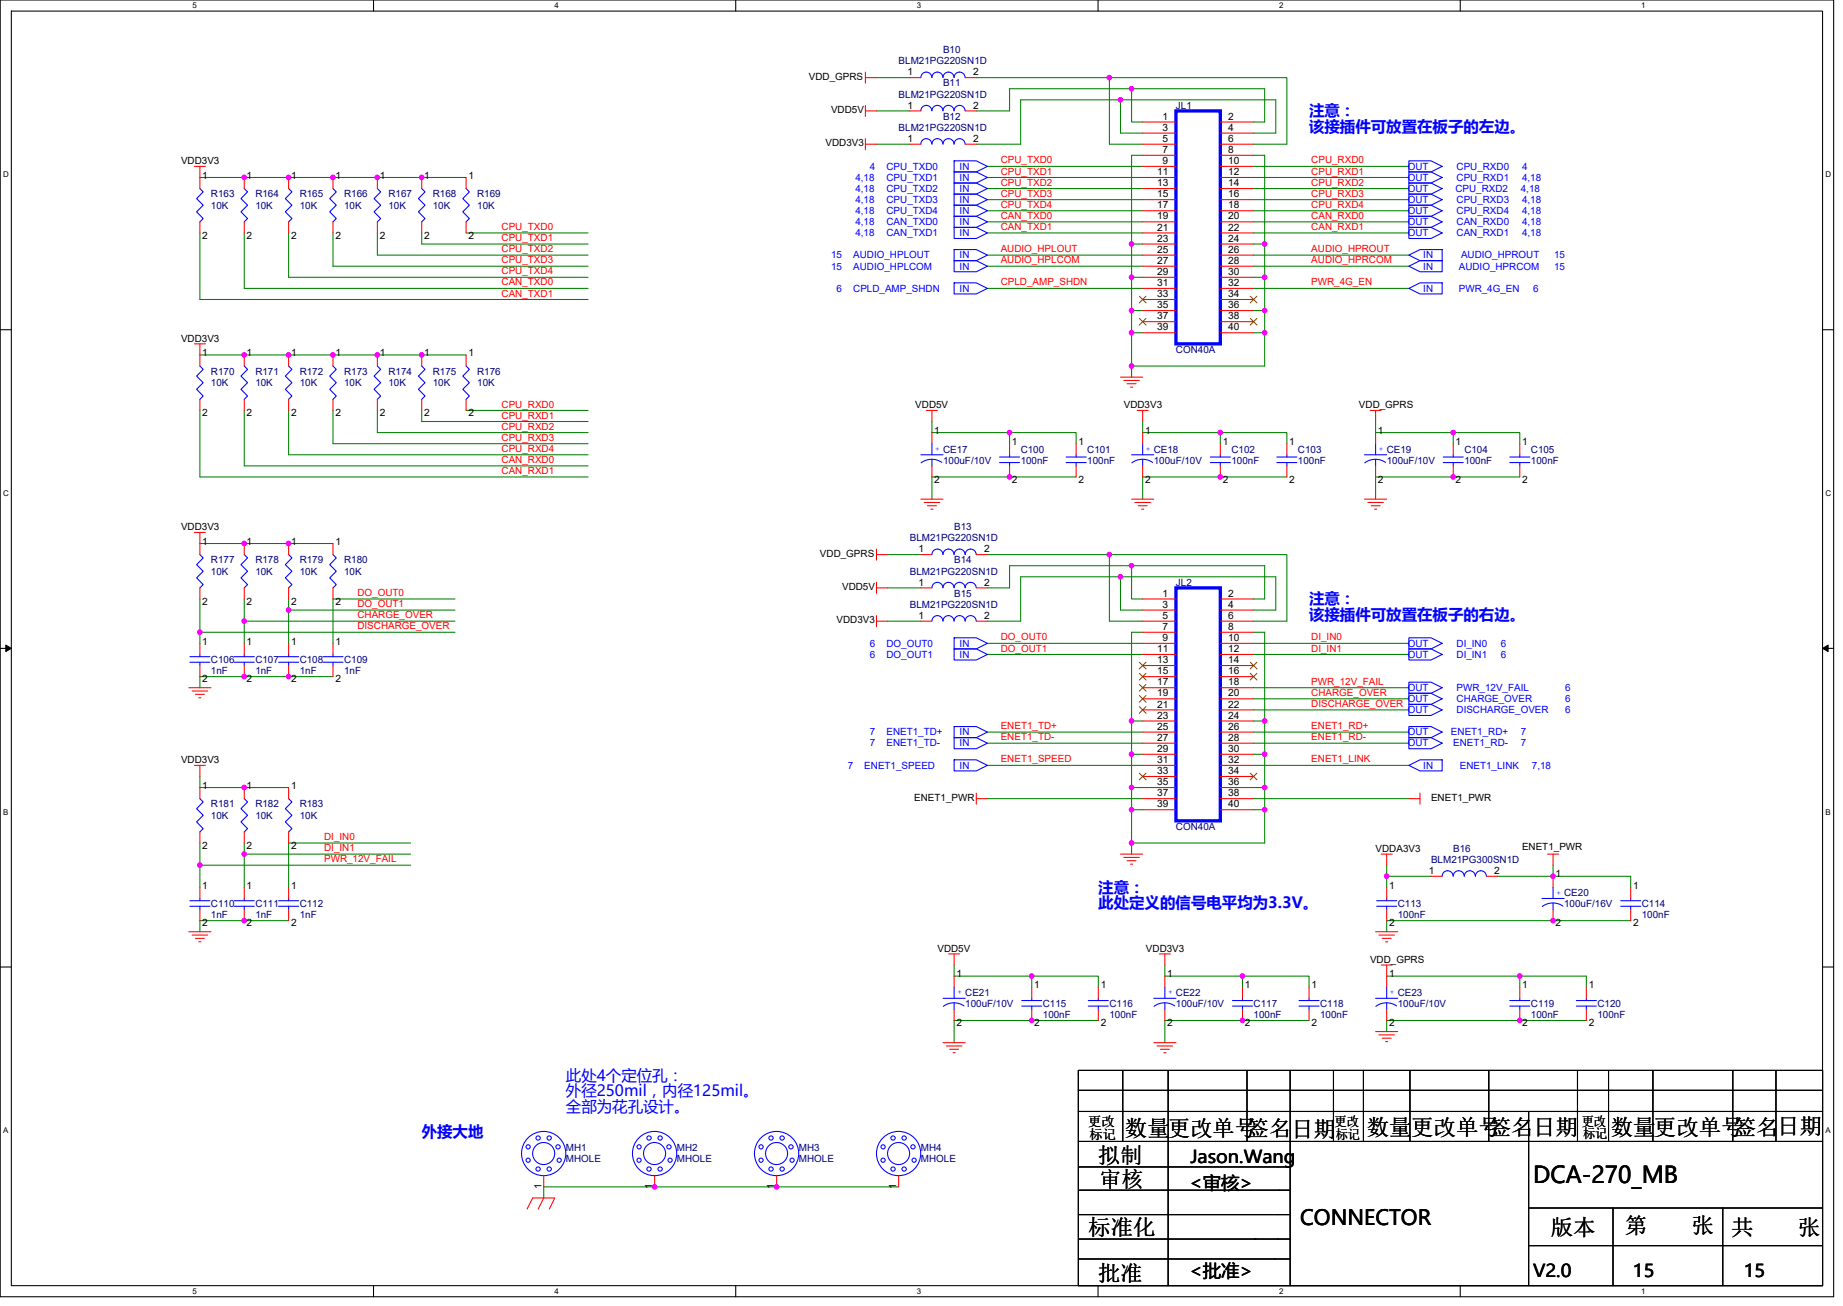
[picture p34: page 15]

标记 标记 标记 | 数量更改单号签名日期 更改 数量更改单号签名日期 更改 数量更改单号签名日期 更改 | | | 更改 更改 更改 标记 标记 标记 | 数量更改单号 数量更改单号 数量更改单号 | | 签名 签名日期 更改标记 数量更改单号 签名 签名日期 更改标记 数量更改单号 签名 签名日期 更改标记 数量更改单号 | 日期 日期 日期
拟制 拟制 拟制 | | Jason.Wang Jason.Wang Jason.Wang | CONNECTOR CONNECTOR CONNECTOR | | | DCA-270_MB DCA-270_MB DCA-270_MB
审核 审核 审核 | | <审核> <审核> <审核>
