gdgly/dca-270/(list of files, drawings)

Other design files:
SCH_160723/DCA_270_EB_V20_160723/DCA_270_EB_V20_160723.DSN
SCH_160723/DCA_270_EB_V20_160723/dca_270_eb_v20_160723.opj
SCH_160723/DCA_270_MB_V20_160723/DCA_270_MB_V20_160723.DSN
SCH_160723/DCA_270_MB_V20_160723/dca_270_mb_v20_160723.opj
