gdgly/dca-270/(commit log)

2016-08-02 DCA-270项目的硬件设计资料，从V2.0开始采用Git来进行版本管理。
    [DCA_270_EB_V20_160723.DSN, DCA_270_EB_V20_160723.csv, DCA_270_MB_V20_160723.DSN, dca_270_eb_v20_160723.opj, dca_270_mb_v20_160723.opj]
2016-08-03 将CPLD设计文档升级至V2.0版本。 并且将文档改名，去掉名字中的日期（因为采用Git版本管理，可以不再加日期区别）
2016-08-03 添加git忽略文件。
2016-08-23 2016年8月23日： CPLD程序做了改动，主要是超级电容充放电指示灯，绿色表示充电过程，红色表示放电过程。将两种颜色指示灯在程序上做了颠倒。 重新编译CPLD程序，并烧写进CPLD内，已经做了验证，逻辑正确。
    [dca_270_eb_v20_160723.opj]
2016-09-05 CPLD程序又做了一次编译，另外增加了BOM清单上需要去掉的器件_160823.docx这篇文档。
    [dca_270_eb_v20_160723.opj]
